kslhuy/CartePCB/Card_CRAN_SEGULA/Card_CRAN_SEGULA_BOM_F.xlsx

Reference | Qty | Description | Package | Manufacturer | Reference | Link
ANT1/ANT2 | 2 | U.FL (UMCC)/I-PEX MHFI_Impedance:50Ohm_max_freq:6GHz_see 3D picture for orientation" | Receptacle, Male Pin | Taoglas Limited | RECE.20279.001E.01 | https://www.digikey.fr/fr/products/detail/taoglas-limited/RECE-20279-001E-01/2332734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
BAT1 | 1 | NEGATIVE TERMINAL indicated by DOT on silkscreen | XT60 CONNECTOR | SparkFun Electronics | 10474 | https://www.digikey.fr/en/products/detail/sparkfun-electronics/10474/8258064
BAT2 | 1 | Connector Header Through Hole, Right Angle 2 position | 0.049" (1.25mm) | pin_2x1_0530480210:MOLEX_530480210 Molex | 530480210 | https://www.digikey.fr/en/products/detail/molex/0530480210/242864?s=N4IgTCBcDaIKwGYAMAWAHEsBGJIC6AvkA
C1 | 1 | 220nF_10%_16V_Ceramic_X7R | 0603 (1608 Metric) | KEMET | C0603C224K4RAC7411 | https://www.digikey.fr/en/products/detail/kemet/C0603C224K4RAC7411/12701088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
C78/C79 | 2 | 100nF_10%_50V_Ceramic_X7R | 0805 (2012 Metric) | KEMET | C0805X104K5RAC3316 | https://www.digikey.fr/en/products/detail/kemet/C0805X104K5RAC3316/10315793
C2/C3/C12/C73/C55/C56/C57/C58/C59/C60/C61/C62/C63/C64/C65/C37/C38/C39/C40/C41/C42/C43/C44/C45/C10/C11/C48/C51/C66/C70/C72/C32/C34/C86/C89 | 35 | 100nF_5%_50V_Ceramic_X7S | 0402 (1005 Metric) | Murata Electronics | GRM155C71H104JE19J | https://www.digikey.fr/en/products/detail/murata-electronics/GRM155C71H104JE19J/10702795
C15/C20 | 2 | 100nF_10%_16V_Ceramic_X7S | 0201 (0603 Metric) | Murata Electronics | GRM033C71C104KE14D | https://www.digikey.fr/en/products/detail/murata-electronics/GRM033C71C104KE14D/5027472
C46/C54 | 2 | 10uF_Molded Tantalum Polymer_10 V_ 200mOhm @ 100kHz (or 300mOhm)_1000 Hrs @ 105°C (or 85°C)8_Polarity indicated by + on silkscreen" | 0805 (2012 Metric) | KEMET | T529P106M010AAE200 | https://www.digikey.fr/en/products/detail/kemet/T529P106M010AAE200/8582783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
C4/C83/C84 | 2 | 10uF_10%_25V_Ceramic_X5R | 0603 (1608 Metric) | Murata Electronics | GRM188R61E106KA73J | https://www.digikey.fr/en/products/detail/murata-electronics/GRM188R61E106KA73J/9887674
C5 | 1 | 0.1uF_5%_50V Ceramic_X7S | 0402 (1005 Metric) | Murata Electronics | GRM155C71H104JE19D | https://www.digikey.fr/en/products/detail/murata-electronics/GRM155C71H104JE19D/8323490
C35/C36/C52/C53 | 4 | 2.2uF_10%_50V_Ceramic_X5R | 0603 (1608 Metric) | Murata Electronics | GRM188R61H225KE11D | https://www.digikey.fr/en/products/detail/murata-electronics/GRM188R61H225KE11D/4905363
C6 | 1 | 2.2uF_10%_50V_Ceramic_X5R | 0603 (1608 Metric) | Murata Electronics | GRM188R61H225KE11D | https://www.digikey.fr/en/products/detail/murata-electronics/GRM188R61H225KE11D/4905363
C76/C77 | 2 | 2.2 µF_10%_16V_Ceramic_X7R | 0805 (2012 Metric) | KEMET | C0805C225K4REC7210 | https://www.digikey.fr/en/products/detail/kemet/C0805C225K4REC7210/8645250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
C16 | 1 | 2.2uF_10%_16V_Ceramic_X7S | 0603 (1608 Metric) | Murata Electronics | GRM188C71C225KE11J | https://www.digikey.fr/en/products/detail/murata-electronics/GRM188C71C225KE11J/10697353
C21 | 1 | 2.2uF_Ceramic_25V_X5R_10% | 0402 (1005 Metric) | Murata Electronics | GRM155R61E225KE11D | https://www.digikey.fr/en/products/detail/murata-electronics/GRM155R61E225KE11D/4905143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
C29/C30 | 2 | 2.2uF_10%_16V_Ceramic_X7S | 0603 (1608 Metric) | Murata Electronics | GRM188C71C225KE11J | https://www.digikey.fr/en/products/detail/murata-electronics/GRM188C71C225KE11J/10697353
C7/C9/C19 | 3 | 10nF_Ceramic_25V_X7R_5% | 0402 (1005 Metric) | KEMET | C0402C103J3RACAUTO | https://www.digikey.fr/en/products/detail/kemet/C0402C103J3RACAUTO/9694225
C31/C33/C87/C88 | 4 | 1uF_10%_25V_Ceramic_X5R | 0603 (1608 Metric) | TDK Corporation | C1608X5R1E105K080AC | https://www.digikey.fr/en/products/detail/tdk-corporation/C1608X5R1E105K080AC/2093414
C47/C69/C71 | 3 | 1uF_Molded_Tantalum_10 V_7.5Ohm_Polarity indicated by + on silkscreen" | 0603 (1608 Metric) | KYOCERA AVX | TACL105K010XTA | https://www.digikey.fr/en/products/detail/kyocera-avx/TACL105K010XTA/1212738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
C8 | 1 | 1uF_-20%_+80%_25V_Ceramic_Y5V (F) | 0603 (1608 Metric) | KEMET | C0603C105Z3VACTU | https://www.digikey.fr/en/products/detail/kemet/C0603C105Z3VACTU/7382059
C22 | 1 | 1uF_10%_16V_Ceramic_X6S | 0402 (1005 Metric) | Murata Electronics | GRM155C81C105KE15D | https://www.digikey.fr/en/products/detail/murata-electronics/GRM155C81C105KE15D/10701217
C26 | 1 | 1uF_Ceramic_35V_X5R_10% | 0402 (1005 Metric) | Murata Electronics | GRM155R6YA105KE11D | https://www.digikey.fr/en/products/detail/murata-electronics/GRM155R6YA105KE11D/4905162
C18 | 1 | 1uF_Ceramic_10V_X7S_10% | 0402 (1005 Metric) | Murata Electronics | GCM155C71A105KE38D | https://www.digikey.fr/en/products/detail/murata-electronics/GCM155C71A105KE38D/6012263
C13/C23 | 2 | 0.47uF_Ceramic_6.3V_X5R_10% | 0201 (0603 Metric) | Murata Electronics | GRM033R60J474KE90J | https://www.digikey.fr/en/products/detail/murata-electronics/GRM033R60J474KE90J/10701512
C14/C24/C25/C27 | 4 | 4.7uF_Ceramic_25V_X6S_10% | 0603 (1608 Metric) | Murata Electronics | GRM188C81E475KE11D | https://www.digikey.fr/en/products/detail/murata-electronics/GRM188C81E475KE11D/3900460
C17 | 1 | 22nF_10%_10V_Ceramic_X5R | 0201 (0603 Metric) | Murata Electronics | GRM033R61A223KE84D | https://www.digikey.fr/en/products/detail/murata-electronics/GRM033R61A223KE84D/4904684
C28 | 1 | 0.22uF_Ceramic_10V_X5R_10% | 0201 (0603 Metric) | Murata Electronics | GRM033R61A224KE90D | https://www.digikey.fr/en/products/detail/murata-electronics/GRM033R61A224KE90D/5027496
C49/C50/C67/C68 | 4 | 10pF_5%_50V_Ceramic_C0G_NP0 | 0402 (1005 Metric) | KYOCERA AVX | KGM05ACG1H100JH | https://www.digikey.fr/en/products/detail/kyocera-avx/KGM05ACG1H100JH/563180
C74/C82 | 2 | 100 µF_35V_Aluminum Electrolytic_160mOhm @ 100kHz_2000 Hrs @ 105°C_Low ESR_High Ripple Current_Polarity indicated by + on silkscreen | Radial, Can - SMD | Panasonic Electronic Components | EEE-FPV101XAV | https://www.digikey.fr/en/products/detail/panasonic-electronic-components/EEE-FPV101XAV/10290451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
C75/C81 | 2 | 47uF_20% 35V Ceramic Capacitor X7R_Low ESL | 2220 (5750 Metric) | TDK Corporation | C5750X7R1V476M230KC | https://www.digikey.fr/en/products/detail/tdk-corporation/C5750X7R1V476M230KC/15930210
C80 | 1 | 4.7nF_5%_25V_Ceramic_C0G_NP0 | 0805 (2012 Metric) | KEMET | C0805C472J3GEC7210 | https://www.mouser.fr/ProductDetail/KEMET/C0805C472J3GEC7210?qs=55YtniHzbhA1RCOcrQWbQg%3D%3D
C85 | 1 | 22pF_5%_10V_Ceramic_C0G_NP0 | 0402 (1005 Metric) | KEMET | C0402C220J8GACTU | https://www.digikey.fr/en/products/detail/kemet/C0402C220J8GACTU/2196440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
D1/D13 | 2 | Blue 470nm LED Indication - Discrete 3.2V | 0603 (1608 Metric) | Dialight | 5990091007F | https://www.digikey.fr/en/products/detail/dialight/5990091007F/9385407?s=N4IgTCBcDaIKwE4EAZkIIyoOwDEQF0BfIA
D3/D5/D7/D9/D15 | 5 | DIODE SCHOTTKY 40V 350MA_Surface Mount | SOD-323 | Diodes Incorporated | SD103AWS-7-F | https://www.digikey.fr/en/products/detail/diodes-incorporated/SD103AWS-7-F/717797
D10/D11 | 2 | Red 633nm LED Indication - Discrete 2.1V | 0603 (1608 Metric) | Dialight | 5990010007F | https://www.digikey.fr/en/products/detail/dialight/5990010007F/9385401?s=N4IgTCBcDaIKwE4EAZkEZXIOwDEQF0BfIA
D12/D14 | 2 | Yellow 590nm LED Indication - Discrete 2.1V | 0603 (1608 Metric) | Dialight | 5990040007F | https://www.digikey.fr/en/products/detail/dialight/5990040007F/9385404?s=N4IgTCBcDaIKwE4EAZkBZXIOwDEQF0BfIA
D16/D17 | 2 | Green 525nm LED Indication - Discrete 3.1V | 0603 (1608 Metric) | Dialight | 5990081007F | https://www.digikey.fr/en/products/detail/dialight/5990081007F/9385406?s=N4IgTCBcDaIKwE4EAZkA4CMqDsAxEAugL5A
FB1/FB3/FB5/FB7/FB9/FB10 | 6 | 120 Ohms @ 100 MHz 1 Power Line Ferrite Bead_2A 55mOhm | 0402 (1005 Metric) | TDK Corporation | MPZ1005S121HT000 | https://www.digikey.fr/en/products/detail/tdk-corporation/MPZ1005S121HT000/6816995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
IC1 | 1 | ARM® Cortex®-M4 STM32F4 Microcontroller IC 32-Bit Single-Core 168MHz 1MB (1M x 8) | 64-LQFP (10x10) | STMicroelectronics | STM32F405RGT6 | https://www.digikey.fr/en/products/detail/stmicroelectronics/STM32F405RGT6/2754208
IC2 | 1 | ARM® Cortex®-M7 STM32H7 Microcontroller IC 32-Bit Single-Core 480MHz 2MB (2M x 8) FLASH | 100-LQFP (14x14) | STMicroelectronics | STM32H753VIT6 | https://www.digikey.fr/en/products/detail/stmicroelectronics/STM32H753VIT6/8257854
J1 | 1 | 9 (8 + 1) Position Card Connector and Ejector Secure Digital - microSD™ Surface Mount_Right Angle Gold |  | Molex | 5033981892 | https://www.digikey.fr/en/products/detail/molex/5033981892/4555393?s=N4IgTCBcDaIKwAYDMSCcAOAtARnaiAugL5A
J2/J3/J4/J5 | 4 | USB 2.0 Receptacle Connector 24 (16+8 Dummy) Position Surface Mount_Right Angle_Solder_See attached 3D picture for orientation | USB-C (USB TYPE-C) | GCT | USB4110-GF-A | https://www.digikey.fr/en/products/detail/gct/USB4110-GF-A/10384547?s=N4IgTCBcDaIKoGUBCAWAjGgDAcQGIEEQBdAXyA
J6/J7 | 2 | Connector Header Surface Mount 10 position | 0.050" (1.27mm) | Harwin Inc. | M50-3600542R | https://www.digikey.fr/en/products/detail/harwin-inc/M50-3600542R/4969871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
J9/J11/J12/J13/J14/J15 | 6 | Connector Header Through Hole, Right Angle 4 position | 0.049" (1.25mm) | Molex | 530480410 | https://www.digikey.fr/en/products/detail/molex/0530480410/242866?s=N4IgTCBcDaIKwGYAMAWAHKgjEkBdAvkA
J16 | 1 | Connector Header Through Hole, Right Angle 6 position | 0.049" (1.25mm) | Molex | 530480610 | https://www.digikey.fr/en/products/detail/molex/0530480610/242868?s=N4IgTCBcDaIKwGYAMAWAHEgbARiSAugL5A
L1 | 1 | 27nH_Unshielded Drum Core_Wirewound_680 mA_288mOhm Max | 0402 (1005 Metric) | Murata Electronics | LQW15AN27NJ8ZD | https://www.digikey.fr/en/products/detail/murata-electronics/LQW15AN27NJ8ZD/6798799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
L2 | 1 | 3.3µH_Unshielded Multilayer_1A_200mOhm | 0805 (2012 Metric) | Würth Elektronik | 74479775233 | https://www.digikey.fr/en/products/detail/w%C3%BCrth-elektronik/74479775233/4862368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
L3 | 1 | 15uH_Shielded Drum Core, Wirewound Inductor 9A 28mOhm Max | 0.531" L x 0.492" W (13.50mm x 12.50mm) | Bourns Inc. | SRP1265A-150M | https://www.digikey.fr/en/products/detail/bourns-inc/SRP1265A-150M/4876621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
R1/R50/R51 | 4 | 10R_0.5%_0.063W_1/16W_Thin Film | 0402 (1005 Metric) | Panasonic Electronic Components | ERA-2AKD100X | https://www.digikey.fr/en/products/detail/panasonic-electronic-components/ERA-2AKD100X/1706054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
R2/R3/R4/R34/R35/R52/R42/R43/R44/R45/R46/R61 | 12 | 10kR_1%_0.125W_1/8W_Thick Film | 0402 (1005 Metric) | TE Connectivity Passive Product | CRGP0402F10K | https://www.digikey.fr/en/products/detail/te-connectivity-passive-product/CRGP0402F10K/8576969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
R63/R64 | 2 | 10 kR_5%_0.25W_1/4W_Thick Film | 0805 (2012 Metric) | Panasonic Electronic Components | ERJ-T06J103V | https://www.digikey.fr/en/products/detail/panasonic-electronic-components/ERJ-T06J103V/2340195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
R5/R41 | 2 | 100R_0.5%_0.333W_1/3W_Thick Film | 0603 (1608 Metric) | Panasonic Electronic Components | ERJ-PA3D1000V | https://www.digikey.fr/en/products/detail/panasonic-electronic-components/ERJ-PA3D1000V/5038262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
R8/R14/R20/R23/R25/R26/R27/R30 | 8 | 100kR_1%_0.1W_1/10W_Thick Film | 0402 (1005 Metric) | Panasonic Electronic Components | ERJ-2RKF1003X | https://www.digikey.fr/en/products/detail/panasonic-electronic-components/ERJ-2RKF1003X/192081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
R9/R17/R21/R22/R24/R28/R29/R31 | 8 | 5.1kR_1%_0.1W_1/10W_Thick Film | 0402 (1005 Metric) | KOA Speer Electronics, Inc. | RK73H1ETTP5101F | https://www.digikey.fr/en/products/detail/koa-speer-electronics-inc/RK73H1ETTP5101F/9844118
R18/R33 | 2 | 1kR_1%_0.063W_1/16W_Thick Film | 0402 (1005 Metric) | YAGEO | RC0402FR-071KL | https://www.digikey.fr/en/products/detail/yageo/RC0402FR-071KL/726513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
R19/R32/R40/R60 | 4 | 330R_0.5%_0.333W_1/3W_Thick Film | 0603 (1608 Metric) | Panasonic Electronic Components | ERJ-PA3D3300V | https://www.digikey.fr/en/products/detail/panasonic-electronic-components/ERJ-PA3D3300V/5038319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
R36/R37/R38/R39/R53/R54/R55/R56 | 8 | 4.7kR_1%_0.2W_1/5W_Thick Film | 0402 (1005 Metric) | KOA Speer Electronics, Inc. | SG73P1ETTP4701F | https://www.digikey.fr/en/products/detail/koa-speer-electronics-inc/SG73P1ETTP4701F/10188081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
R57 | 1 | 47R_0.5%_0.063W_1/16W_Thin Film | 0402 (1005 Metric) | Panasonic Electronic Components | ERA-2AED470X | https://www.digikey.fr/en/products/detail/panasonic-electronic-components/ERA-2AED470X/1706070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
R62 | 1 | 0.01R_1%_2W | 2512 (6432 Metric) | YAGEO | PE2512FKE7W0R01Z | https://www.digikey.fr/en/products/detail/yageo/PE2512FKE7W0R01Z/12698905
R65 | 1 | 19.6kR_0.1%_0.25W_1/4W_Thick Film | 0805 (2012 Metric) | Panasonic Electronic Components | ERJ-PB6B1962V | https://www.digikey.fr/en/products/detail/panasonic-electronic-components/ERJ-PB6B1962V/6213522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
R66 | 1 | 6.8kR_1%_0.25W_1/4W_Thick Film | 0805 (2012 Metric) | KOA Speer Electronics, Inc. | RK73H2ATTD6R80F | https://www.digikey.fr/en/products/detail/koa-speer-electronics-inc/RK73H2ATTD6R80F/10233949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
R67 | 1 | 1.3kR_1% _0.25W_1/4W_Thick Film | 0805 (2012 Metric) | KOA Speer Electronics, Inc. | RK73H2ATTD1301F | https://www.digikey.fr/en/products/detail/koa-speer-electronics-inc/RK73H2ATTD1301F/10234163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
R68 | 1 | 560R_1%_0.333W_1/3W_Thick Film | 0603 (1608 Metric) | Panasonic Electronic Components | ERJ-PA3F5600V | https://www.digikey.fr/en/products/detail/panasonic-electronic-components/ERJ-PA3F5600V/5035938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
R69 | 1 | 240R_1%_0.333W_1/3W_Thick Film | 0603 (1608 Metric) | Panasonic Electronic Components | ERJ-PA3F2400V | https://www.digikey.fr/en/products/detail/panasonic-electronic-components/ERJ-PA3F2400V/5035893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
R70/R71 | 2 | 620R_1%_0.333W_1/3W_Thick Film | 0603 (1608 Metric) | Panasonic Electronic Components | ERJ-PA3F6200V | https://www.digikey.fr/en/products/detail/panasonic-electronic-components/ERJ-PA3F6200V/5035943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
R72/R76 | 2 | 22.1kR_1%_0.063W_1/16W_Thick Film | 0402 (1005 Metric) | YAGEO | RC0402FR-0722K1L | https://www.digikey.fr/en/products/detail/yageo/RC0402FR-0722K1L/726563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
R73/R77 | 2 | 47.5kR_1%_0.1W_1/10W_Thick Film | 0402 (1005 Metric) | KOA Speer Electronics, Inc. | RK73H1ETTP4752F | https://www.digikey.fr/en/products/detail/koa-speer-electronics-inc/RK73H1ETTP4752F/9844111
R74/R75 | 2 | 0R_Jumper_1/8W_Thick Film | 0603 (1608 Metric) | Vishay Dale | RCS06030000Z0EC | https://www.digikey.fr/en/products/detail/vishay-dale/RCS06030000Z0EC/10059623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
REG1 | 1 | Buck Switching Regulator IC Positive Adjustable 0.8V 1 Output 9A | 28-QFN (5x6) | Microchip Technology | MIC26903YJL-TR | https://www.digikey.fr/en/products/detail/microchip-technology/MIC26903YJL-TR/2747223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
SW1/SW2/SW4 | 3 | Dip Switch SPDT 2 Position Surface Mount Slide (Standard) Actuator 25mA 24VDC | 0.236" (6.00mm) | C&K | TDD01H0SB1R | https://www.digikey.fr/en/products/detail/c-k/TDD01H0SB1R/4966368?s=N4IgTCBcDaICoBEEAYCMAJZBlAQqgSiALoC%2BQA
SW3/SW5 | 2 | Tactile Switch SPST-NO 0.05A 12V Top Actuated Surface Mount |  | Alps Alpine | SKQGADE010 | https://www.digikey.fr/en/products/detail/alps-alpine/SKQGADE010/18109115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
TP1/TP2/TP3/TP4 | 4 | TestPoint | Pad_D1.5mm
U1 | 1 | Magnetoresistive Sensor X, Y, Z Axis | 12-LGA (2x2) | STMicroelectronics | IIS2MDCTR | https://www.digikey.fr/en/products/detail/stmicroelectronics/IIS2MDCTR/7927708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
U2 | 1 | Accelerometer X, Y, Z Axis ±2g, 4g, 8g, 16g 6.25Hz ~ 16kHz | 14-LGA (2.5x3) | TDK InvenSense | IIM-42652 | https://www.digikey.fr/en/products/detail/tdk-invensense/IIM-42652/13901975
U3 | 1 | M9 RF Receiver BeiDou, Galileo, GLONASS, GNSS, GPS -167dBm | 24-SMD Module | u-blox | NEO-M9N-00B | https://www.digikey.fr/en/products/detail/u-blox/NEO-M9N-00B/12149174
U4/U5 | 2 | EEPROM Memory IC 128Kbit I2C 1 MHz 450 ns | SC-74A/SOT-753 | Microchip Technology | 24CW1280T-I/OT | https://www.digikey.fr/en/products/detail/microchip-technology/24CW1280T-I-OT/9606899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
U6 | 1 | IC RF TxRx Only WiFi 802.11a/b/g/-c/ax, Bluetooth, GPS 2.4GHz, 5GHz | 48-VFQFN Exposed Pad | Nordic Semiconductor ASA | NRF7002-QFAA-R | https://www.digikey.fr/en/products/detail/nordic-semiconductor-asa/NRF7002-QFAA-R/17738488
U7 | 1 | FLASH - NAND Memory IC 1Gbit SPI 104 MHz | 8-WDFN Exposed Pad | Winbond Electronics | W25N01GVZEIG TR | https://www.digikey.fr/en/products/detail/winbond-electronics/W25N01GVZEIG-TR/5803931
U8 | 1 | RF Diplexer 2.4GHz ~ 2.5GHz / 4.9GHz ~ 5.95GHz | 0603 (1608 Metric), 6 PC Pad | TDK Corporation | DPX165950DT-8148A1 | https://www.digikey.fr/en/products/detail/tdk-corporation/DPX165950DT-8148A1/6468701
U9/U10 | 2 | USB Bridge, USB to UART USB 2.0 UART Interface | 20-QFN (3x3) | Silicon Labs | CP2102N-A02-GQFN20R | https://www.digikey.fr/en/products/detail/silicon-labs/CP2102N-A02-GQFN20R/9863478
U11 | 1 | Current Monitor Regulator High-Side 10mA | SOT-23-8 | Texas Instruments | INA219AIDCNR | https://www.digikey.fr/en/products/detail/texas-instruments/INA219AIDCNR/1952540
U12 | 1 | Linear Voltage Regulator IC Positive Fixed 1 Output 2A | 6-DFN (3x3) | STMicroelectronics | LD39200PU33R | https://www.mouser.fr/ProductDetail/STMicroelectronics/LD39200PU33R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
U13/U14 | 2 | 17V Clamp 5A (8/20µs) Ipp Tvs Diode Surface Mount | SOT-23-6 | STMicroelectronics | USBLC6-2SC6 | https://www.digikey.fr/en/products/detail/stmicroelectronics/USBLC6-2SC6/1040559
X1 | 1 | 40 MHz ±10ppm Crystal 8pF 50 Ohms 4-SMD, No Lead | 0.079" L x 0.063" W (2.00mm x 1.60mm) | Diodes Incorporated | FW4000044Q | https://www.digikey.fr/en/products/detail/diodes-incorporated/FW4000044Q/9952926
X2/X3 | 2 | 25 MHz ±30ppm Crystal 10pF 60 Ohms | 4-SMD (3.2x2.5) | Abracon LLC | ABM8G-25.000MHZ-4Y-T3 | https://www.digikey.fr/en/products/detail/abracon-llc/ABM8G-25-000MHZ-4Y-T3/2623797
JP1, JP6 | 2 | SolderJumper-3_Pole | 1.3mm_Open_RoundedPad1.0x1.5mm
H1/H2/H3/H4 | 4 | MountingHole_3.2mm_M3_Pad_Via_PTH
