kslhuy/CartePCB/nav_f405_test/calibration/accel_6pos_calibration.png

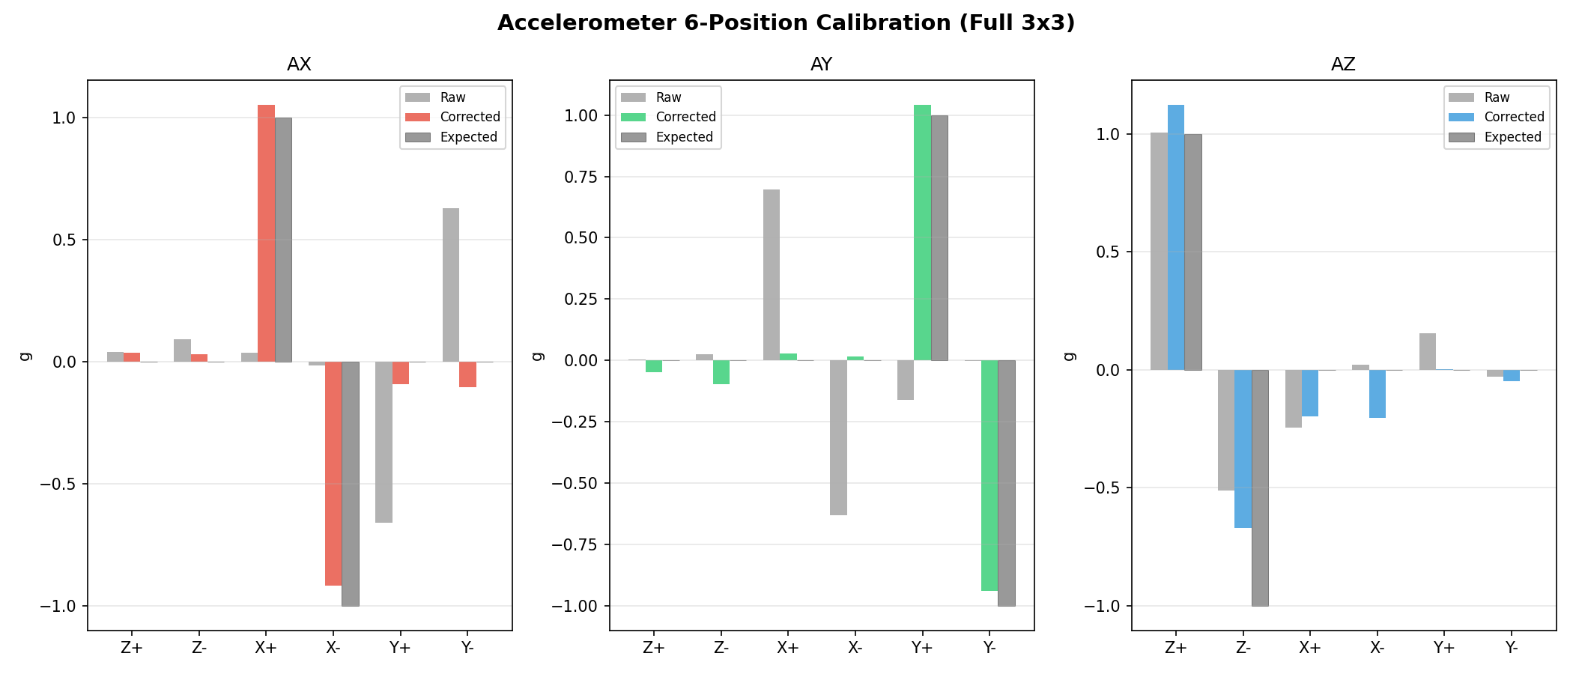
nav_f405_test/calibration/accel_6pos_calibration.png
