kslhuy/CartePCB/nav_f405_test/calibration/allan_deviation.png

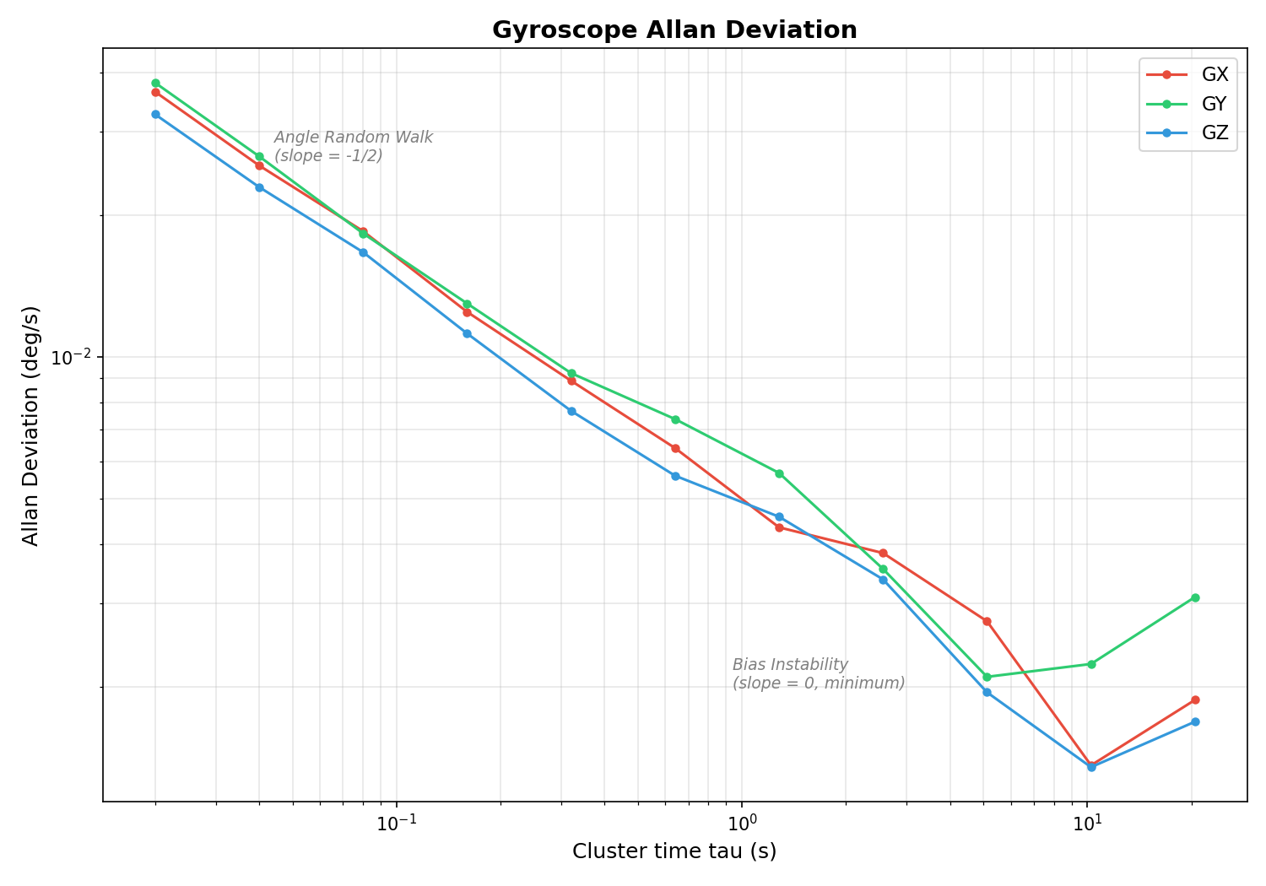
nav_f405_test/calibration/allan_deviation.png
