kslhuy/CartePCB/nav_f405_test/calibration/ferraris_calibration.png

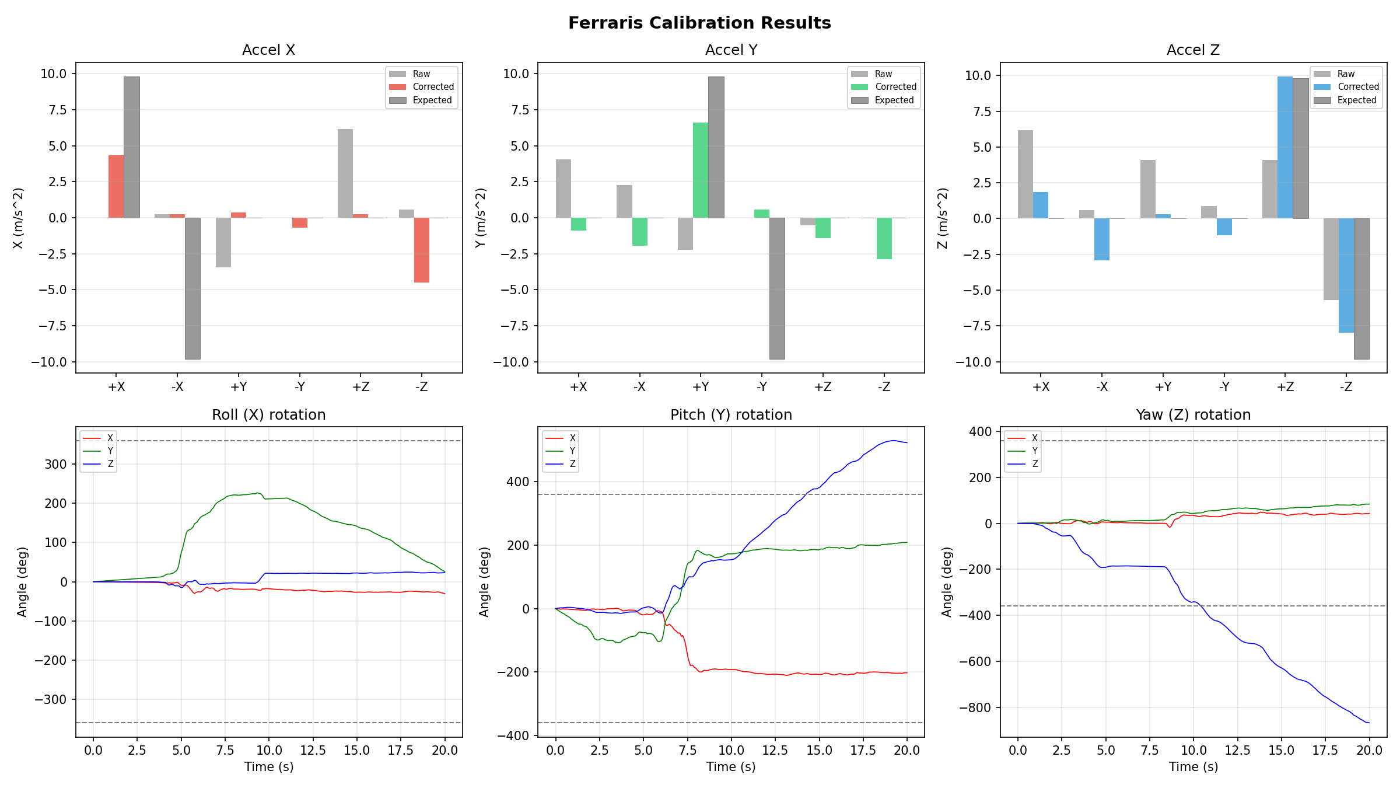
nav_f405_test/calibration/ferraris_calibration.png
