kslhuy/CartePCB/nav_f405_test/calibration/gyro_noise_analysis.png

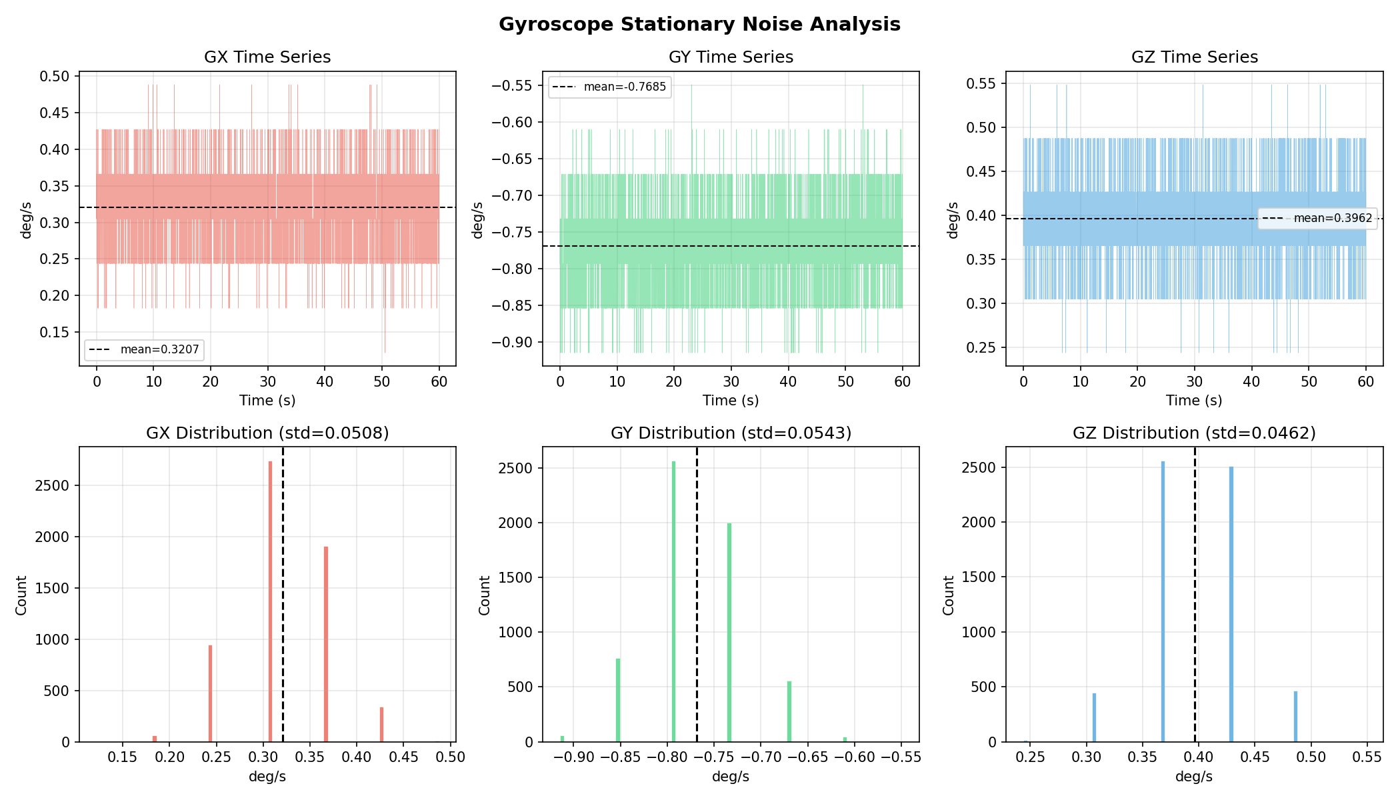
nav_f405_test/calibration/gyro_noise_analysis.png
