kslhuy/CartePCB/nav_f405_test/calibration/imu_analysis.png

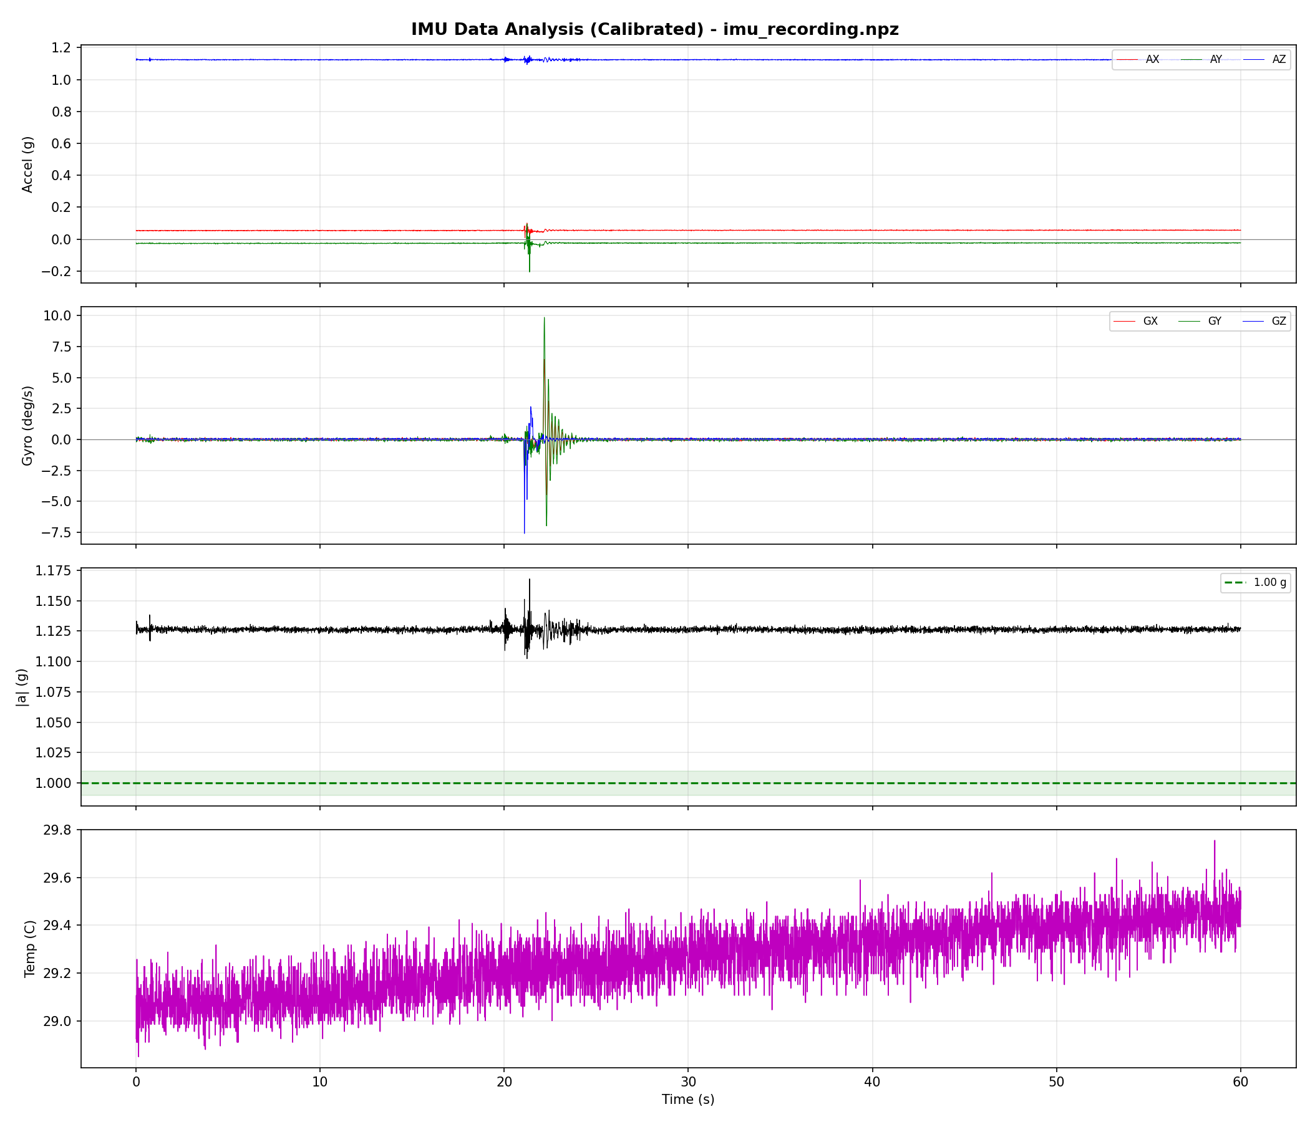
nav_f405_test/calibration/imu_analysis.png
