kslhuy/CartePCB/nav_f405_test/calibration/imu_statistics.png

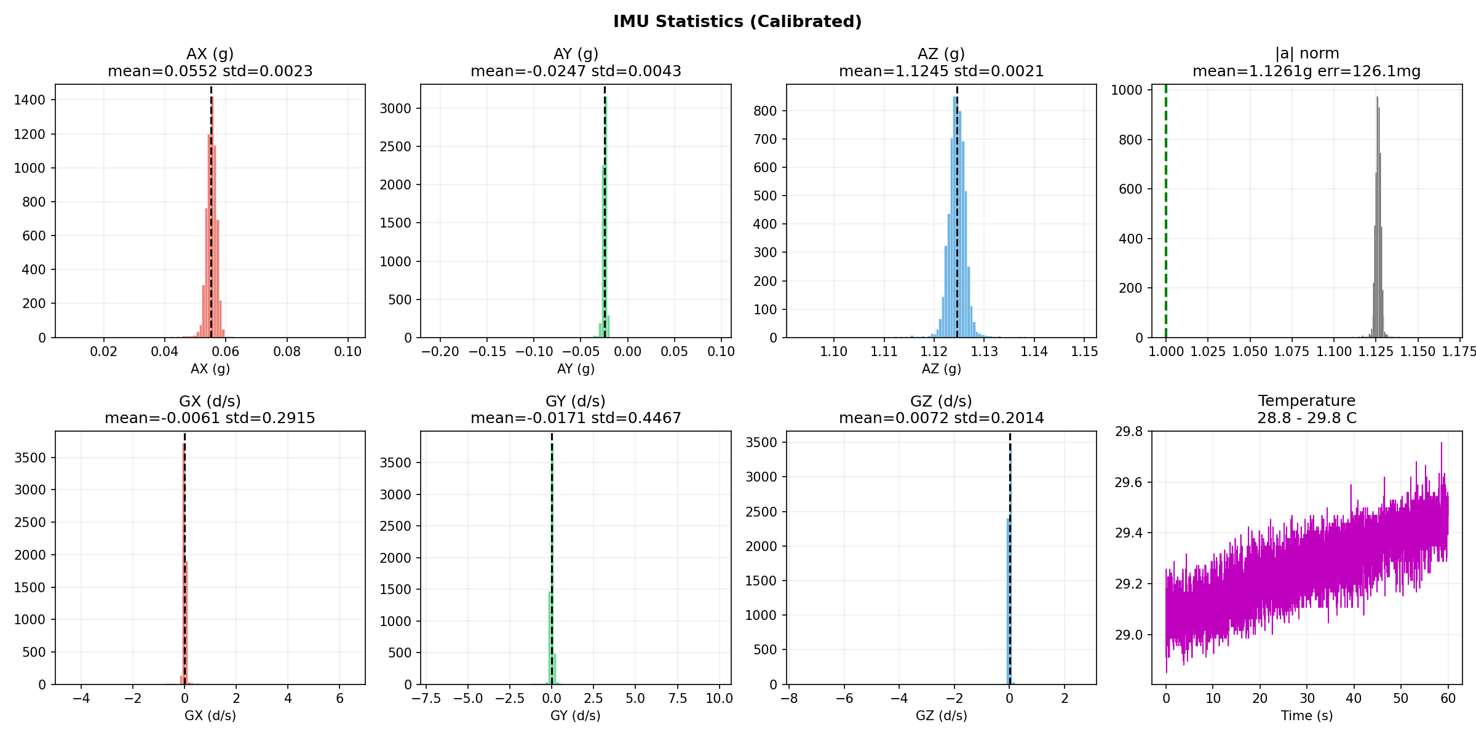
nav_f405_test/calibration/imu_statistics.png
