kslhuy/CartePCB/nav_f405_test/calibration/raw_vs_calibrated.png

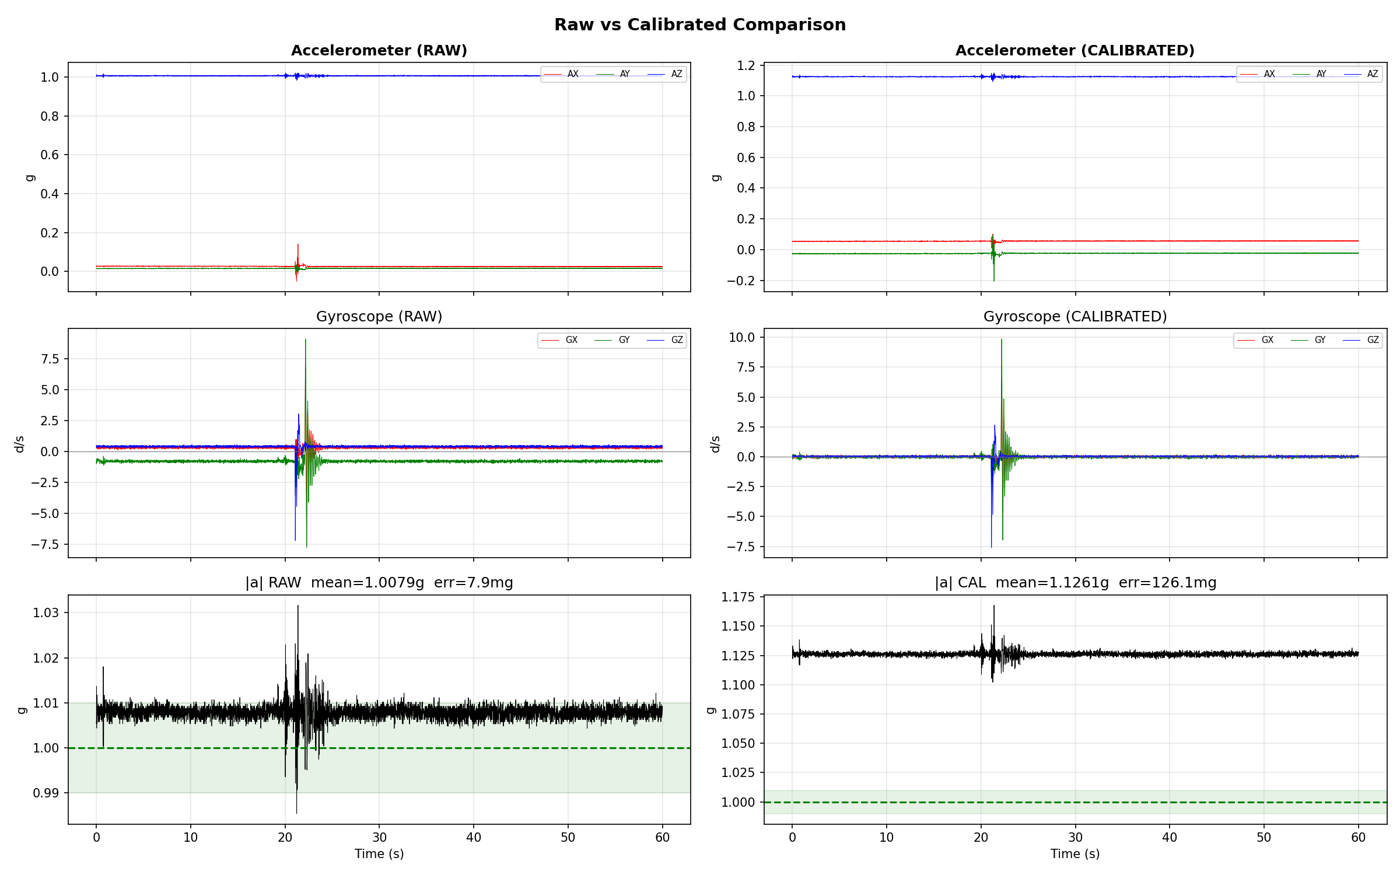
nav_f405_test/calibration/raw_vs_calibrated.png
