kslhuy/CartePCB/Card_CRAN_SEGULA/Card_CRAN_SEGULA.kicad_pcb

## KiCad design Card_CRAN_SEGULA/Card_CRAN_SEGULA.kicad_pcb (2026-03-03)

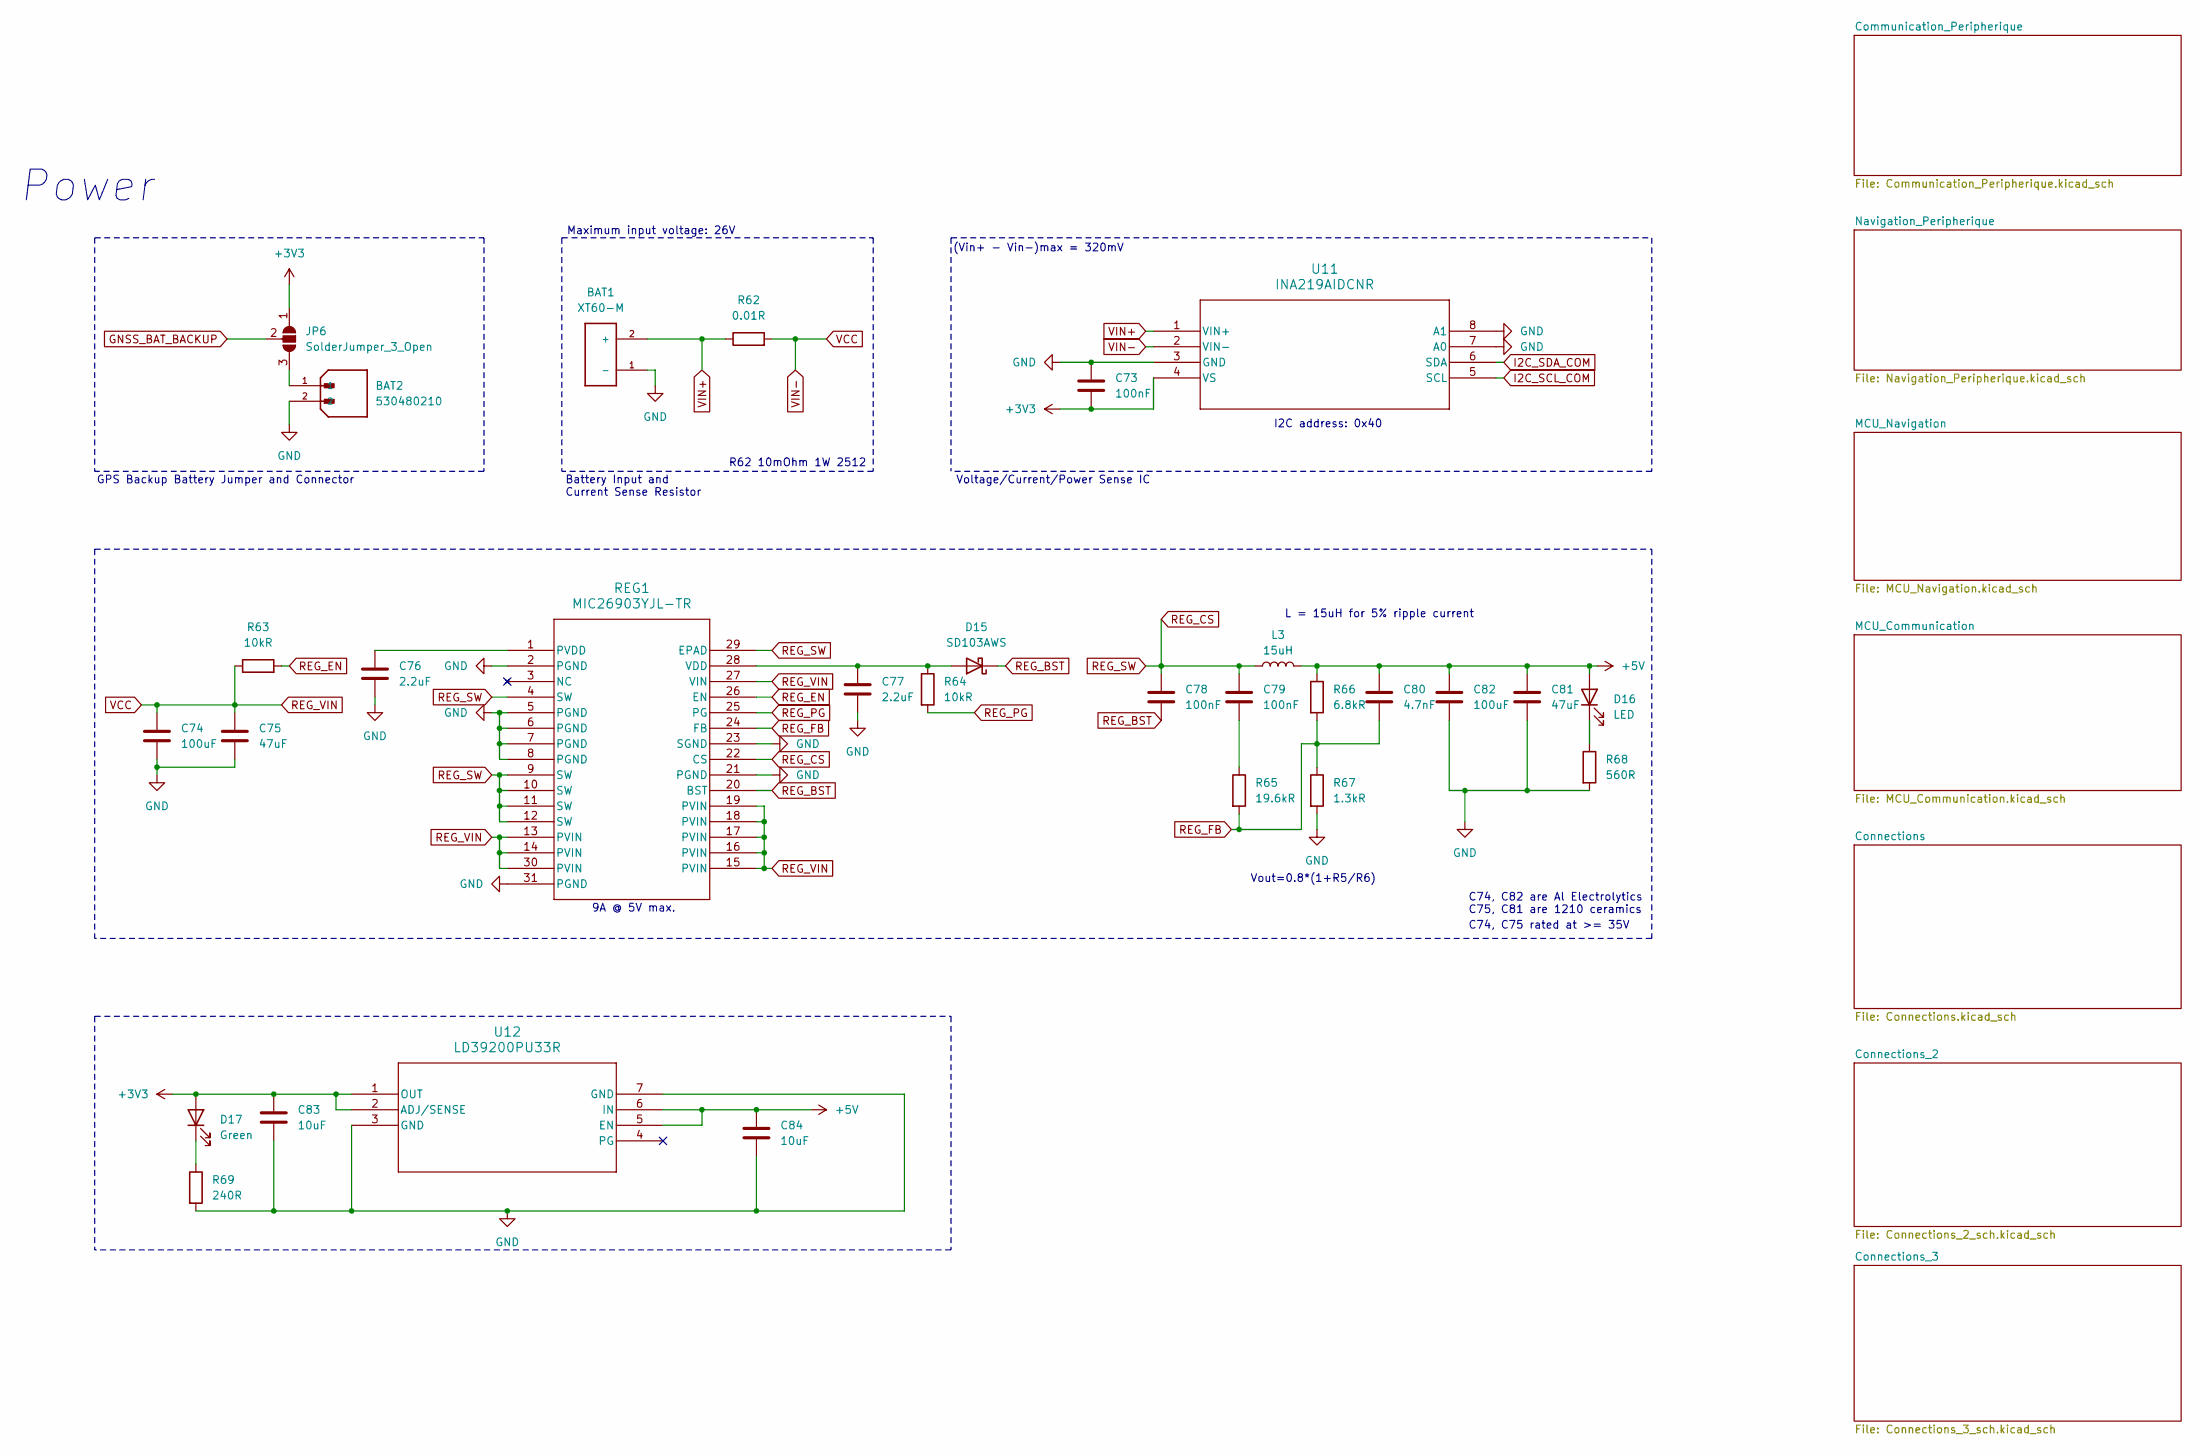
[picture p8: schematic Card_CRAN_SEGULA.kicad_sch, Carte_Embarquée_CRAN_SEGULA]

Parts:
BAT1: XT60-M; AMASS_XT60-M
BAT2: 530480210; MOLEX_530480210; PARTREV A
C73: 100nF; CAPC1005X55N
C74, C82: 100uF; CAP_EEEFPV101XAV
C75, C81: 47uF; CAP_C5750X7R1V476M230KC
C76, C77: 2.2uF; CAPC220145_140N_KEM
C78, C79: 100nF; CAPC230155_120N_KEM
C80: 4.7nF; CAPC220145_100N_KEM
C83, C84: 10uF; CAPC1608X100N
D15: SD103AWS; D_SOD-323
D16: LED; 599-0081-007F_DIA
D17: Green; 599-0081-007F_DIA
JP6: SolderJumper_3_Open; SolderJumper-3_P1.3mm_Open_RoundedPad1.0x1.5mm
L3: 15uH; IND_SRP1265A-150M
R62: 0.01R; RES_PE2512_YAG
R63, R64: 10kR; RESC2012X70N
R65: 19.6kR; RES_ERJ-PB6B1962V
R66: 6.8kR; RESC2012X60N
R67: 1.3kR; RK73H2ATTD1301F
R68: 560R; RES_ERJPA3F5600V
R69: 240R; RES_ERJPA3F2400V
REG1: MIC26903YJL-TR; MIC24054YJLTR
U11: INA219AIDCNR; DCN8
U12: LD39200PU33R; SON_DFN6_3X3_STM

Connections:
+5V: C80.1, C81.1, C82.1, C84.1, D16.2 (A), L3.2, R66.1, U12.5 (EN), U12.6 (IN); also elsewhere on the board
GND: BAT1.1 (-), BAT2.2, C73.1, C74.2, C75.2, C76.2, C77.2, C81.2, C82.2, C83.2, C84.2, R67.2, R68.2, R69.2, REG1.2 (PGND), REG1.5 (PGND), REG1.6 (PGND), REG1.7 (PGND), REG1.8 (PGND), REG1.21 (PGND), REG1.23 (SGND), REG1.31 (PGND), U11.3 (GND), U11.7 (A0), U11.8 (A1), U12.3 (GND), U12.7 (GND); also elsewhere on the board
GNSS_BAT_BACKUP: JP6.2 (C); also elsewhere on the board
I2C_SCL_COM: U11.5 (SCL); also elsewhere on the board
I2C_SDA_COM: U11.6 (SDA); also elsewhere on the board
unnamed: C79.2, R65.1
unnamed: C77.1, D15.2 (A), R64.1, REG1.28 (VDD)
unnamed: D16.1 (K), R68.1
unnamed: D17.1 (K), R69.1
unnamed: BAT2.1, JP6.3 (B)
unnamed: C76.1, REG1.1 (PVDD)
REG_BST: C78.2, D15.1 (K), REG1.20 (BST)
REG_CS: C78.1, C79.1, L3.1, REG1.4 (SW), REG1.9 (SW), REG1.10 (SW), REG1.11 (SW), REG1.12 (SW), REG1.22 (CS), REG1.29 (EPAD)
REG_EN: R63.2, REG1.26 (EN)
REG_FB: C80.2, R65.2, R66.2, R67.1, REG1.24 (FB)
REG_PG: R64.2, REG1.25 (PG)
REG_VIN: C74.1, C75.1, R62.2, R63.1, REG1.13 (PVIN), REG1.14 (PVIN), REG1.15 (PVIN), REG1.16 (PVIN), REG1.17 (PVIN), REG1.18 (PVIN), REG1.19 (PVIN), REG1.27 (VIN), REG1.30 (PVIN), U11.2 (VIN-)
VIN+: BAT1.2 (+), R62.1, U11.1 (VIN+)
WIFI_BUCVBATS: C73.2, C83.1, D17.2 (A), JP6.1 (A), U11.4 (VS), U12.1 (OUT), U12.2 (ADJ/SENSE); also elsewhere on the board

Notes on the sheet:
Vout=0.8*(1+R5/R6)
R62 10mOhm 1W 2512
Maximum input voltage: 26V
9A @ 5V max.
Battery Input and Current Sense Resistor
I2C address: 0x40
C74, C82 are Al Electrolytics C75, C81 are 1210 ceramics
L = 15uH for 5% ripple current
Voltage/Current/Power Sense IC
GPS Backup Battery Jumper and Connector
(Vin+ - Vin-)max = 320mV
C74, C75 rated at >= 35V
Power

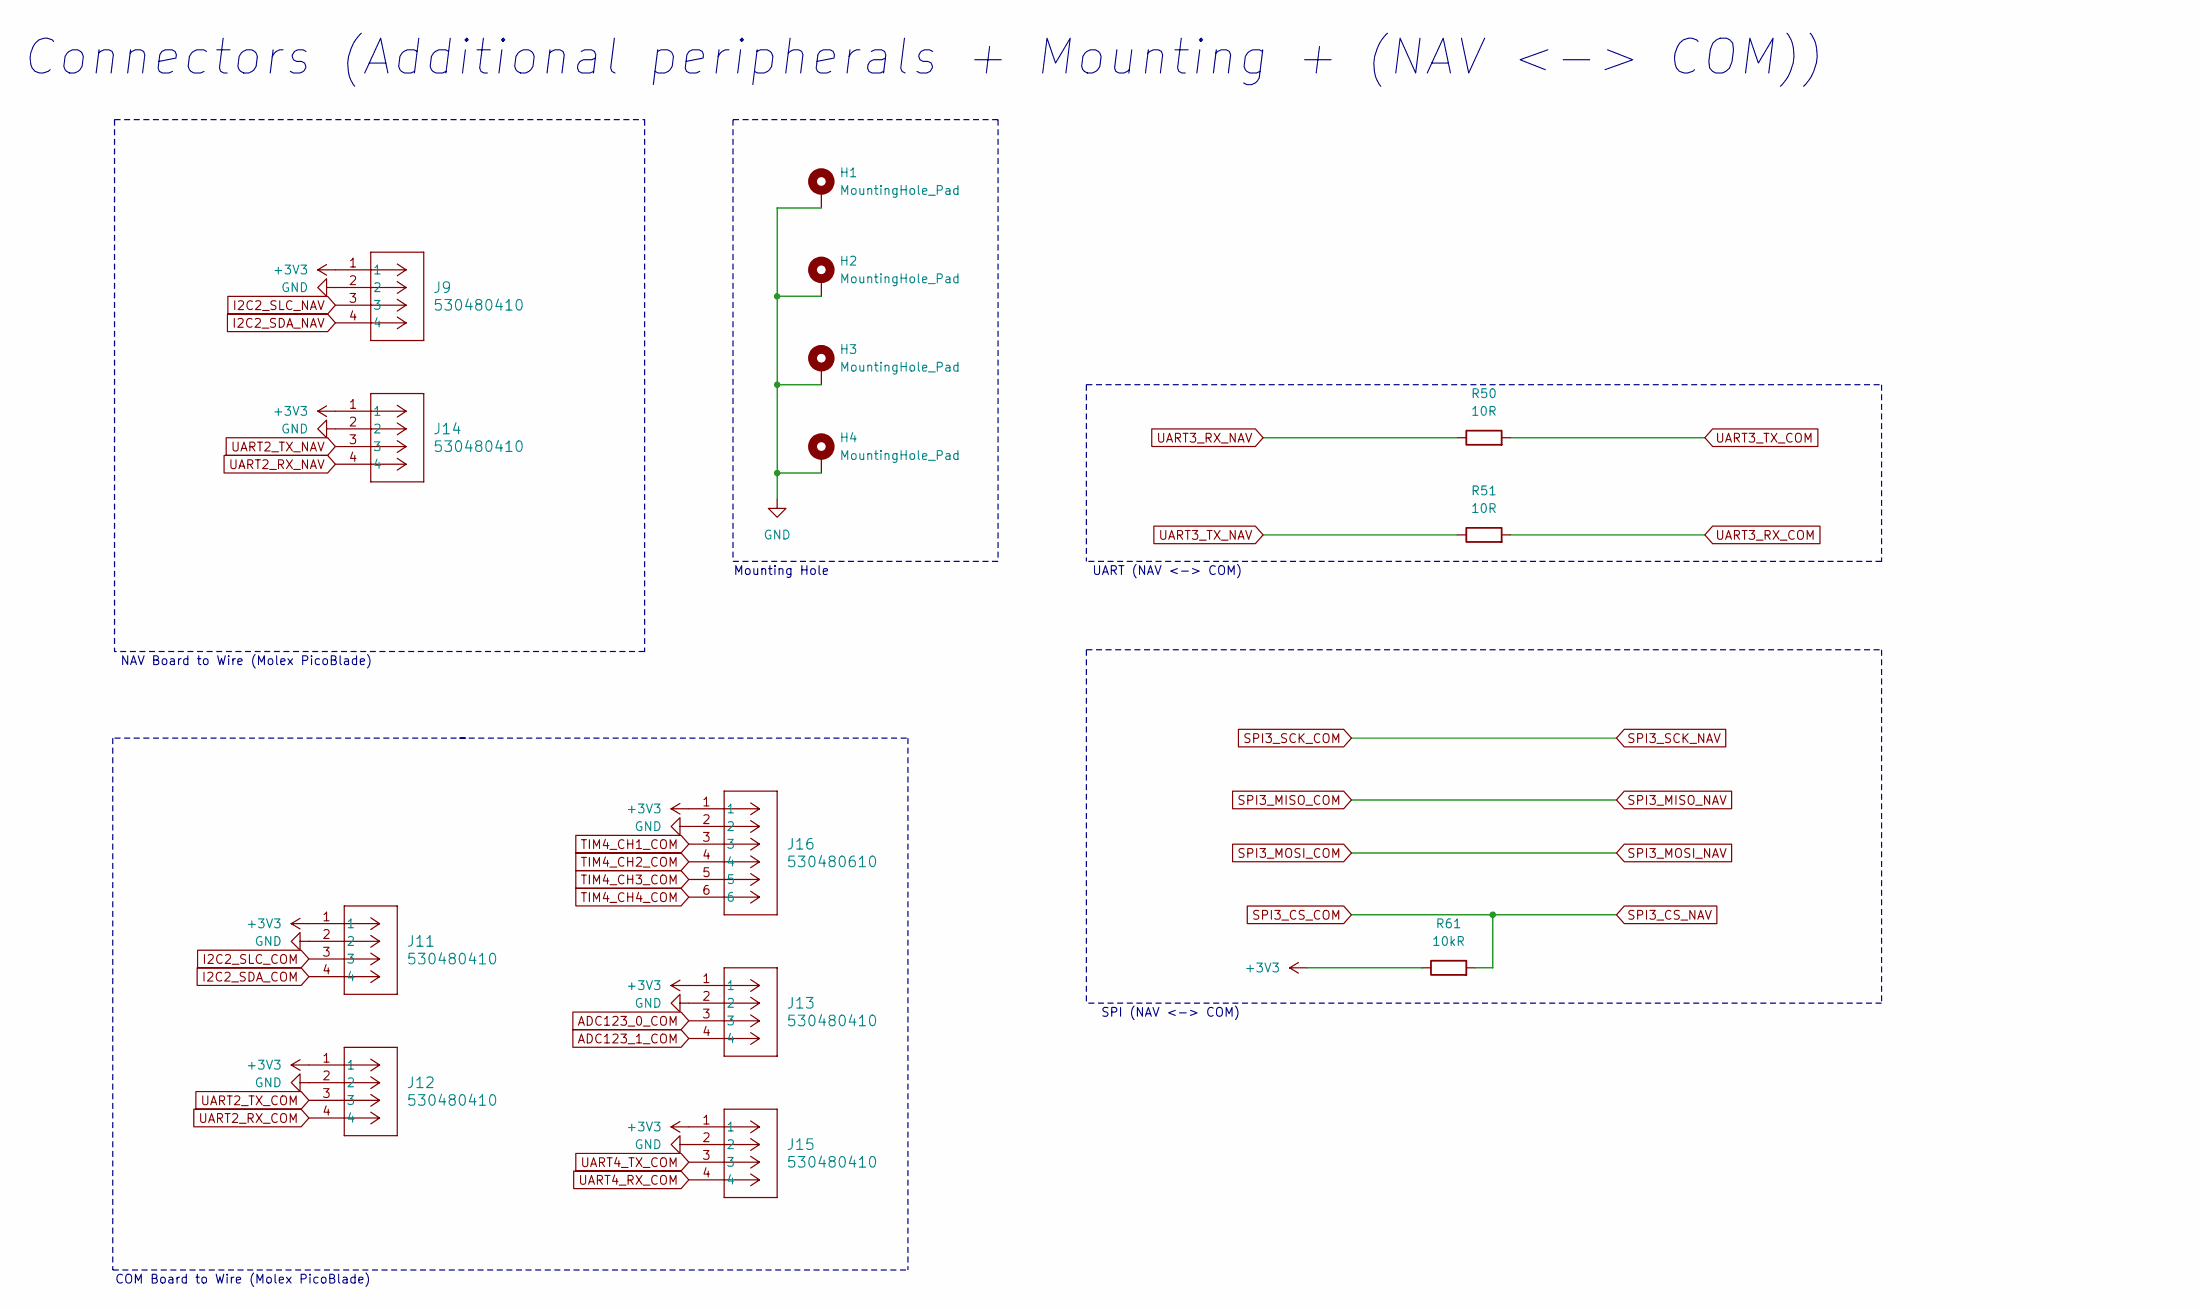
[picture p9: schematic Connections_3_sch.kicad_sch, Carte_Embarquée_CRAN_SEGULA]

Parts:
H1, H2, H3, H4: MountingHole_Pad; MountingHole_3.2mm_M3_Pad_Via
J9, J11, J12, J13, J14, J15: 530480410; CONN04_530480410_MOL
J16: 530480610; CONN06_530480610_MOL
R50, R51: 10R; RES_ERA2AKD100X
R61: 10kR; RESC1105X40N

Connections:
ADC123_0_COM: J13.3; also elsewhere on the board
ADC123_1_COM: J13.4; also elsewhere on the board
GND: H1.1, H2.1, H3.1, H4.1, J9.2, J11.2, J12.2, J13.2, J14.2, J15.2, J16.2; also elsewhere on the board
I2C2_SDA_COM: J11.4; also elsewhere on the board
I2C2_SDA_NAV: J9.4; also elsewhere on the board
I2C2_SLC_COM: J11.3; also elsewhere on the board
I2C2_SLC_NAV: J9.3; also elsewhere on the board
SPI3_CS_COM: R61.2; also elsewhere on the board
TIM4_CH1_COM: J16.3; also elsewhere on the board
TIM4_CH2_COM: J16.4; also elsewhere on the board
TIM4_CH3_COM: J16.5; also elsewhere on the board
TIM4_CH4_COM: J16.6; also elsewhere on the board
UART2_RX_COM: J12.4; also elsewhere on the board
UART2_RX_NAV: J14.4; also elsewhere on the board
UART2_TX_COM: J12.3; also elsewhere on the board
UART2_TX_NAV: J14.3; also elsewhere on the board
UART3_RX_COM: R51.2; also elsewhere on the board
UART3_RX_NAV: R50.1; also elsewhere on the board
UART3_TX_COM: R50.2; also elsewhere on the board
UART3_TX_NAV: R51.1; also elsewhere on the board
UART4_RX_COM: J15.4; also elsewhere on the board
UART4_TX_COM: J15.3; also elsewhere on the board
WIFI_BUCVBATS: J9.1, J11.1, J12.1, J13.1, J14.1, J15.1, J16.1, R61.1; also elsewhere on the board

Notes on the sheet:
NAV Board to Wire (Molex PicoBlade)
SPI (NAV <-> COM)
UART (NAV <-> COM)
COM Board to Wire (Molex PicoBlade)
Connectors (Additional peripherals + Mounting + (NAV <-> COM))
Mounting Hole

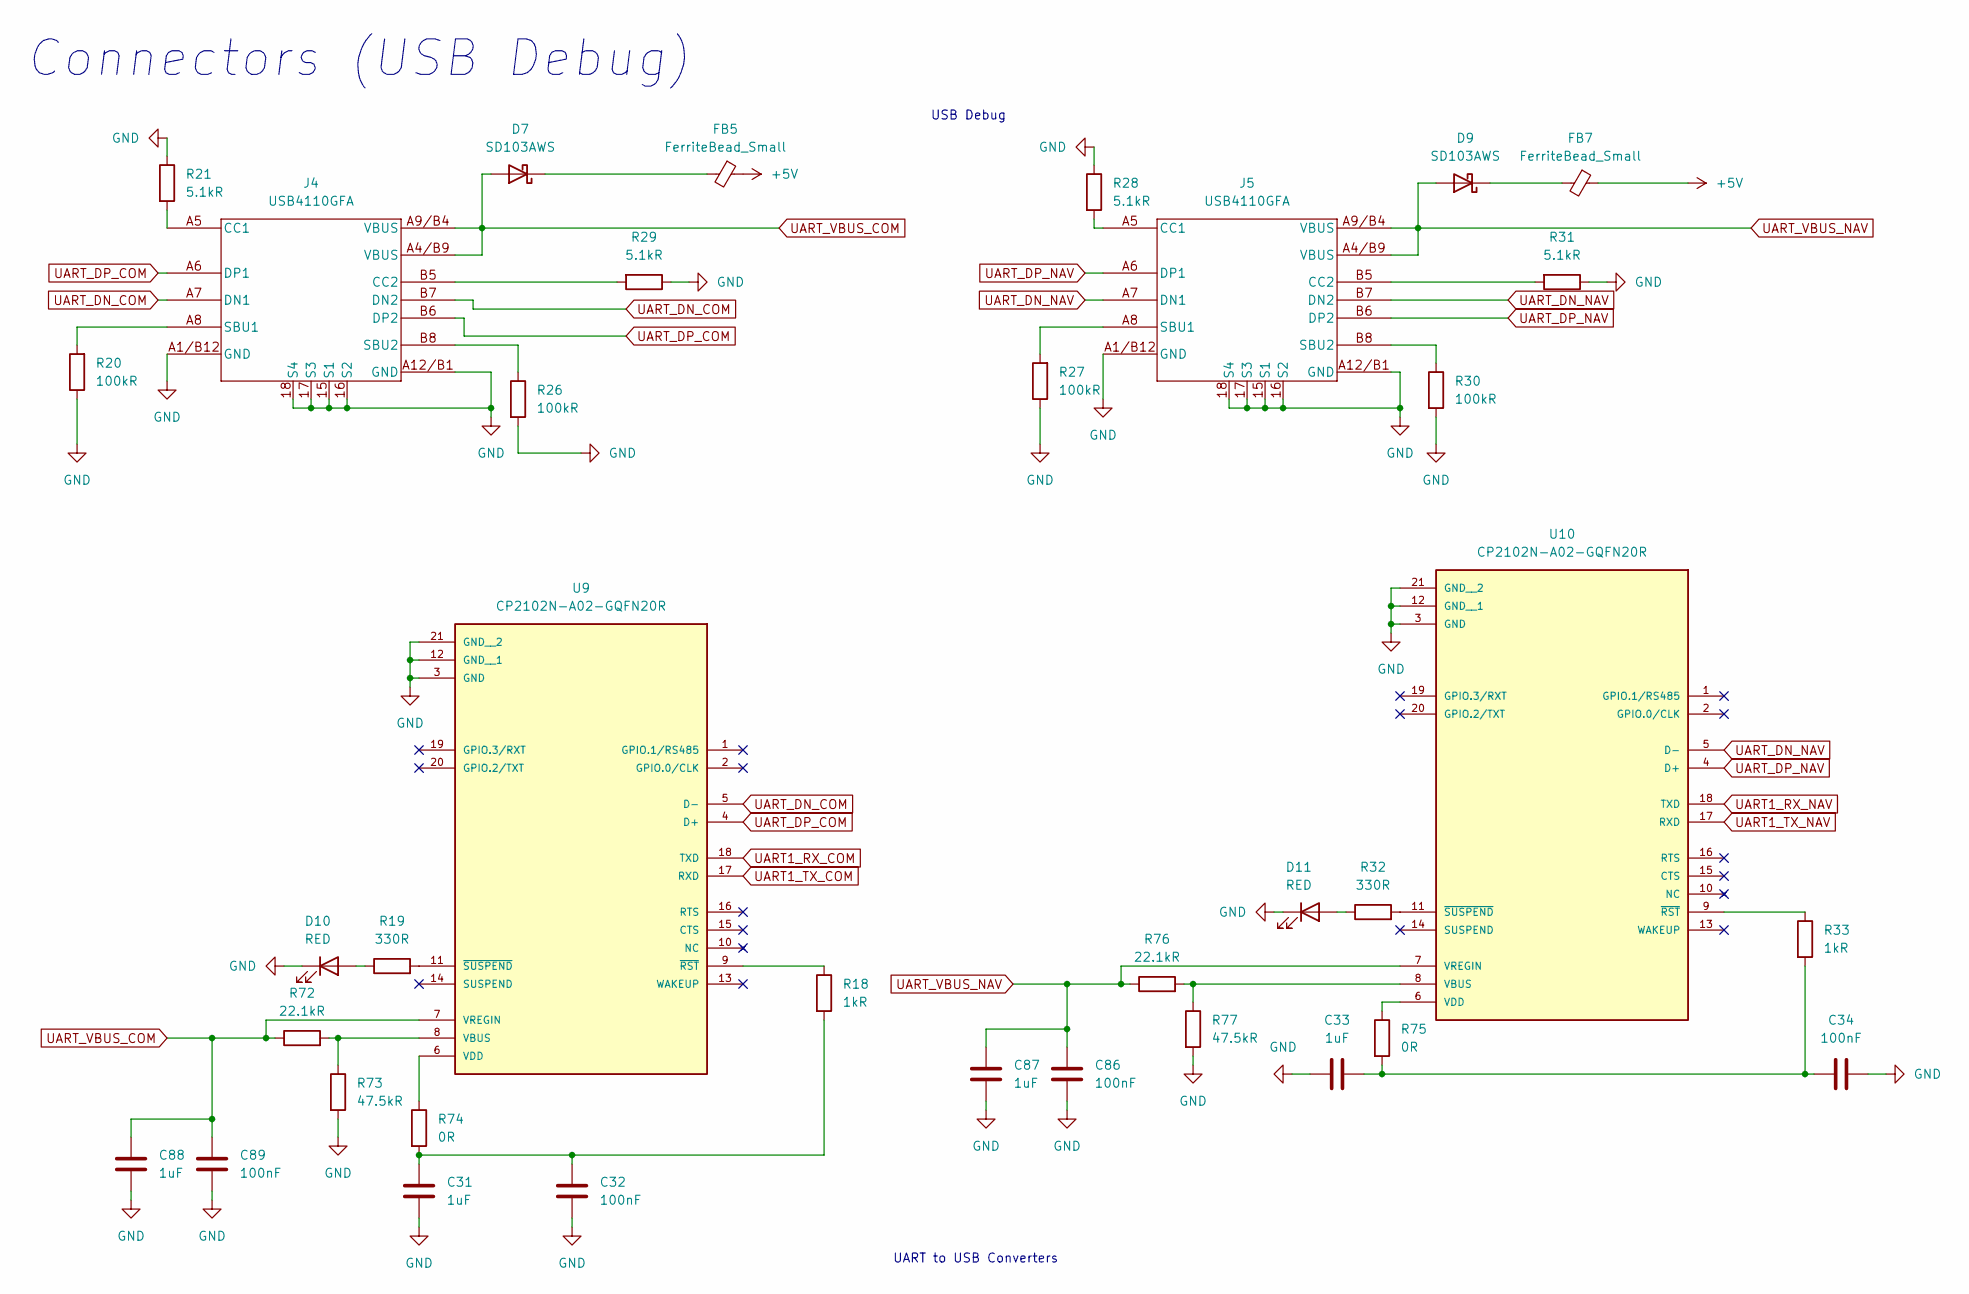
[picture p10: schematic Connections_2_sch.kicad_sch, Carte_Embarquée_CRAN_SEGULA]

Parts:
C31, C33, C87, C88: 1uF; CAPC17595_90N_KEM
C32, C34, C86, C89: 100nF; CAPC1005X55N
D7, D9: SD103AWS; D_SOD-323
D10, D11: RED; 599-0001-007F_DIA
FB5, FB7: FerriteBead_Small; L_0402_1005Metric
J4, J5: USB4110GFA; USB4110-GF-A_GCT
R18, R33: 1kR; RESC1005X40N
R19, R32: 330R; RES_ERJPA3D3300V
R20, R26, R27, R30: 100kR; RES_ERJ2RKF1003X
R21, R28, R29, R31: 5.1kR; RES_ERJ2RKF5101X
R72, R76: 22.1kR; RESC1005X40N
R73, R77: 47.5kR; RESC1005X40N
R74, R75: 0R; RESC1508X50N
U9, U10: CP2102N-A02-GQFN20R; QFN20_SIL; PARTREV 1.3

Connections:
+5V: FB5.1, FB7.1; also elsewhere on the board
GND: C31.2, C32.2, C33.2, C34.2, C86.2, C87.2, C88.2, C89.2, D10.1 (K), D11.1 (K), J4.15 (S1), J4.16 (S2), J4.17 (S3), J4.18 (S4), J4.A1/B12 (GND), J4.A12/B1 (GND), J5.15 (S1), J5.16 (S2), J5.17 (S3), J5.18 (S4), J5.A1/B12 (GND), J5.A12/B1 (GND), R20.1, R21.1, R26.2, R27.1, R28.1, R29.1, R30.2, R31.1, R73.2, R77.2, U9.3 (GND), U9.12 (GND__1), U9.21 (GND__2), U10.3 (GND), U10.12 (GND__1), U10.21 (GND__2); also elsewhere on the board
unnamed: C31.1, C32.1, R18.2, R74.2
unnamed: C33.1, C34.1, R33.2, R75.2
unnamed: D7.1 (K), FB5.2
unnamed: D9.1 (K), FB7.2
unnamed: D10.2 (A), R19.1
unnamed: D11.2 (A), R32.1
unnamed: J4.A5 (CC1), R21.2
unnamed: J4.B5 (CC2), R29.2
unnamed: J4.A8 (SBU1), R20.2
unnamed: J4.B8 (SBU2), R26.1
unnamed: J5.A5 (CC1), R28.2
unnamed: J5.B5 (CC2), R31.2
unnamed: J5.A8 (SBU1), R27.2
unnamed: J5.B8 (SBU2), R30.1
unnamed: R72.2, R73.1, U9.8 (VBUS)
unnamed: R74.1, U9.6 (VDD)
unnamed: R18.1, U9.9 (~RST)
unnamed: R19.2, U9.11 (~SUSPEND)
unnamed: R76.2, R77.1, U10.8 (VBUS)
unnamed: R75.1, U10.6 (VDD)
unnamed: R33.1, U10.9 (~RST)
unnamed: R32.2, U10.11 (~SUSPEND)
UART1_RX_COM: U9.18 (TXD); also elsewhere on the board
UART1_RX_NAV: U10.18 (TXD); also elsewhere on the board
UART1_TX_COM: U9.17 (RXD); also elsewhere on the board
UART1_TX_NAV: U10.17 (RXD); also elsewhere on the board
UART_DN_COM: J4.A7 (DN1), J4.B7 (DN2), U9.5 (D-)
UART_DN_NAV: J5.A7 (DN1), J5.B7 (DN2), U10.5 (D-)
UART_DP_COM: J4.A6 (DP1), J4.B6 (DP2), U9.4 (D+)
UART_DP_NAV: J5.A6 (DP1), J5.B6 (DP2), U10.4 (D+)
UART_VBUS_COM: C88.1, C89.1, D7.2 (A), J4.A4/B9 (VBUS), J4.A9/B4 (VBUS), R72.1, U9.7 (VREGIN)
UART_VBUS_NAV: C86.1, C87.1, D9.2 (A), J5.A4/B9 (VBUS), J5.A9/B4 (VBUS), R76.1, U10.7 (VREGIN)

Notes on the sheet:
UART to USB Converters
USB Debug
Connectors (USB Debug)

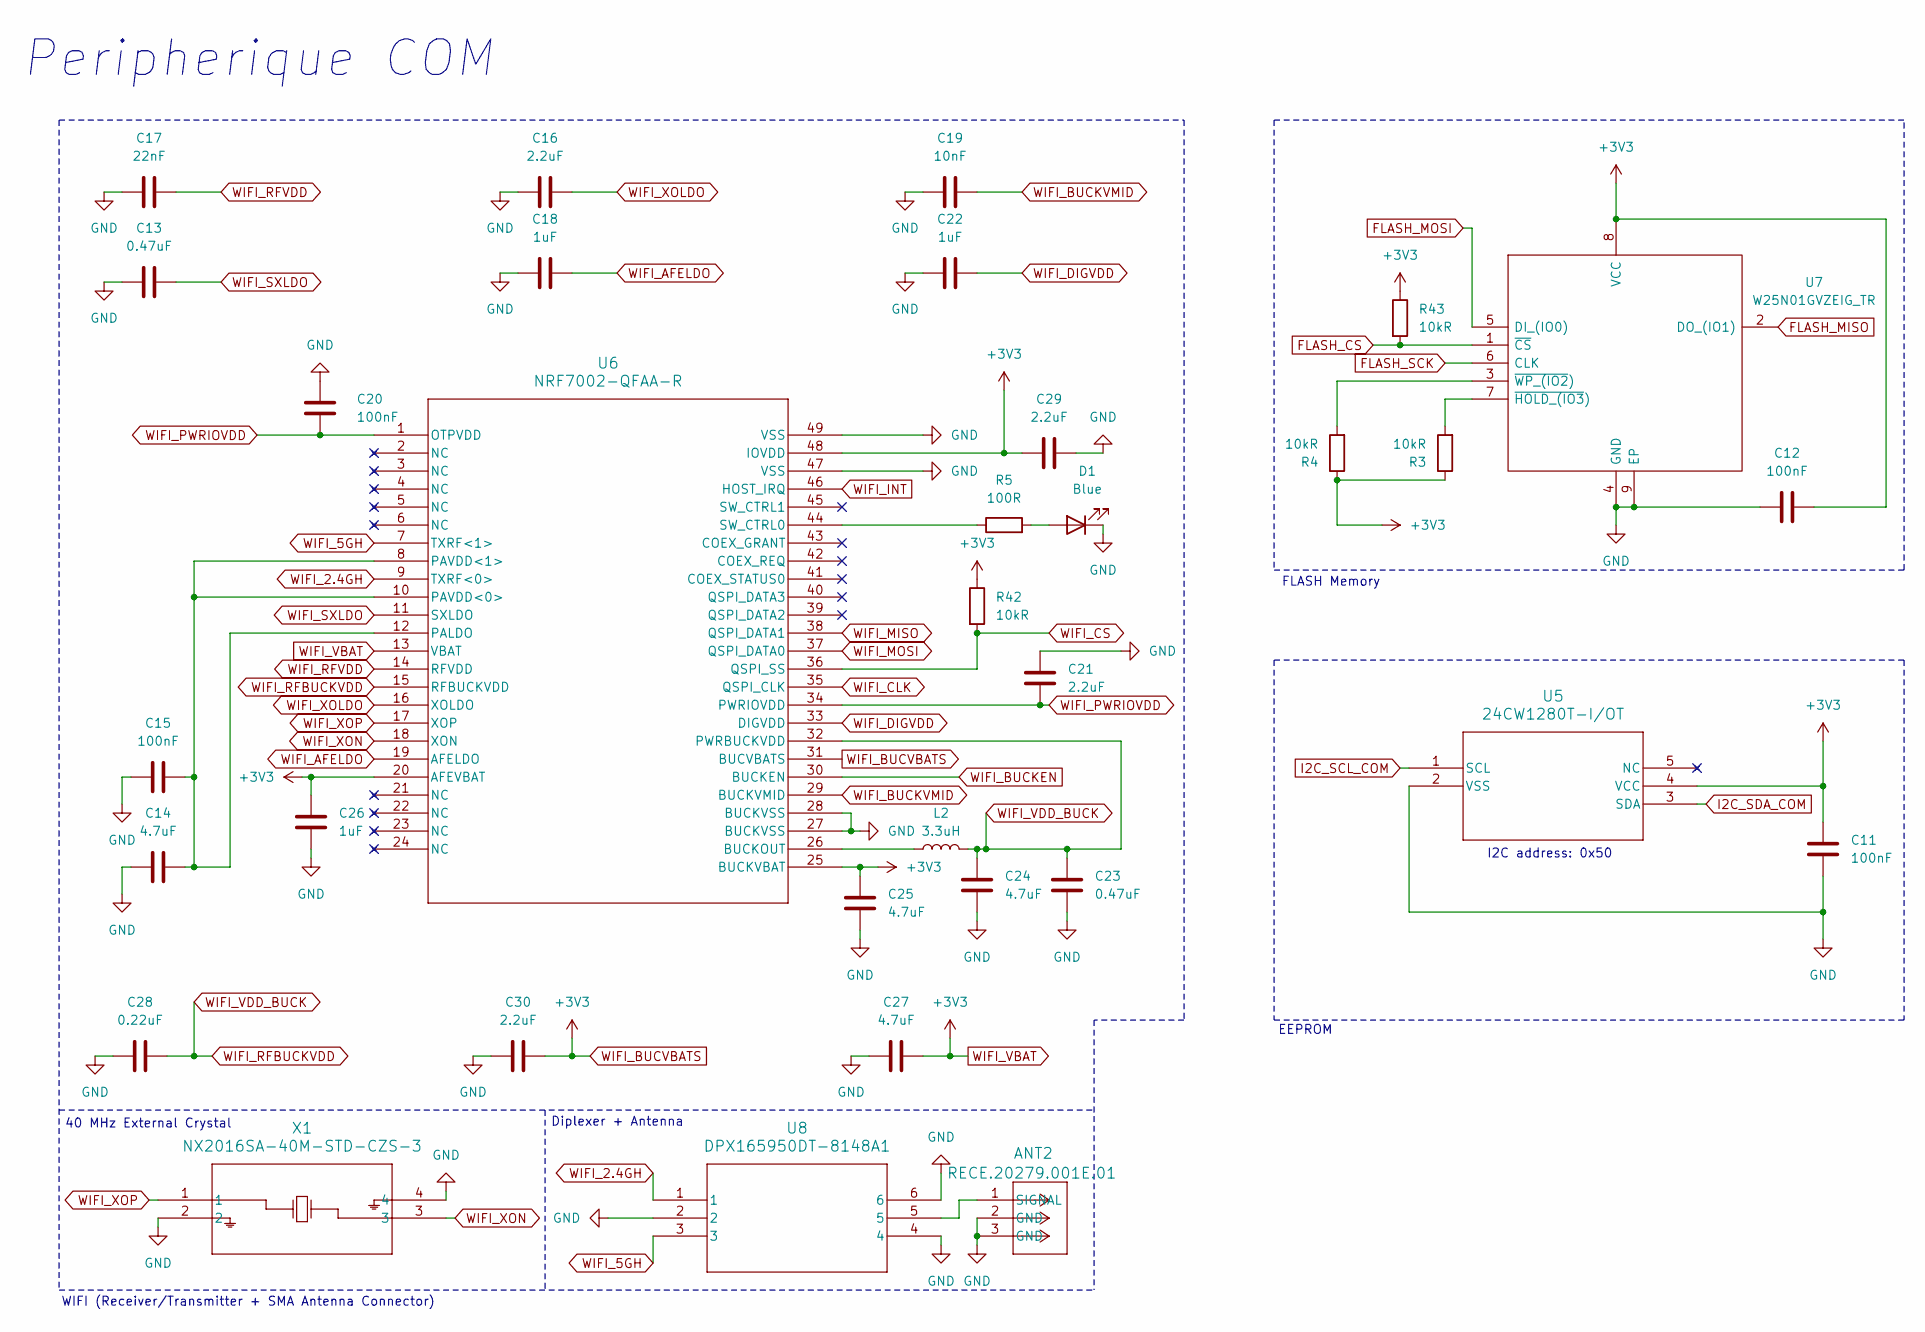
[picture p11: schematic Communication_Peripherique.kicad_sch, Carte_Embarquée_CRAN_SEGULA]

Parts:
ANT2: RECE.20279.001E.01; CON3_RECE.20279.001E.01_TAL
C11, C12: 100nF; CAPC1005X55N
C13, C23: 0.47uF; CAPC0603X33N
C14, C24, C25, C27: 4.7uF; CAPC1608X100N
C15, C20: 100nF; CAPC0603X33N
C16, C29, C30: 2.2uF; CAPC1608X100N
C17: 22nF; CAPC0603X33N
C18: 1uF; CAPC1005X70N
C19: 10nF; CAPC1005X55N
C21: 2.2uF; CAPC1005X70N
C22, C26: 1uF; CAPC1005X60N
C28: 0.22uF; CAPC0603X33N
D1: Blue; 599-0091-007F_DIA
L2: 3.3uH; WE-PMI_0805_H1
R3, R4, R42, R43: 10kR; RESC1105X40N
R5: 100R; RES_ERJPA3D1000V
U5: 24CW1280T-I/OT; SOT-23-5_2P9X1P6_MCH
U6: NRF7002-QFAA-R; QFN48_6X6_NOR
U7: W25N01GVZEIG_TR; SON127P800X600X80-9N-D; Manufacturer_Part_Number W25N01GVZEIG TR; Mouser Part Number 454-W25N01GVZEIGTR
U8: DPX165950DT-8148A1; RF_5049A1_TDK
X1: NX2016SA-40M-STD-CZS-3; NX2016SA-40M-STD-CZS-3_NDK

Connections:
FLASH_CS: R43.2, U7.1 (~CS); also elsewhere on the board
FLASH_MISO: U7.2 (DO_(IO1)); also elsewhere on the board
FLASH_MOSI: U7.5 (DI_(IO0)); also elsewhere on the board
FLASH_SCK: U7.6 (CLK); also elsewhere on the board
GND: ANT2.2 (GND), ANT2.3 (GND), C11.2, C12.1, C13.1, C14.2, C15.1, C16.1, C17.2, C18.1, C19.1, C20.1, C21.1, C22.1, C23.2, C24.2, C25.2, C26.1, C27.1, C28.1, C29.2, C30.1, D1.1 (K), U5.2 (VSS), U6.27 (BUCKVSS), U6.28 (BUCKVSS), U6.47 (VSS), U6.49 (VSS), U7.4 (GND), U7.9 (EP), U8.2, U8.4, U8.6, X1.2, X1.4; also elsewhere on the board
I2C_SCL_COM: U5.1 (SCL); also elsewhere on the board
I2C_SDA_COM: U5.3 (SDA); also elsewhere on the board
unnamed: ANT2.1 (SIGNAL), U8.5
unnamed: D1.2 (A), R5.2
unnamed: L2.1, U6.26 (BUCKOUT)
unnamed: C14.1, C15.2, U6.8 (PAVDD<1>), U6.10 (PAVDD<0>), U6.12 (PALDO)
unnamed: R5.1, U6.44 (SW_CTRL0)
unnamed: R3.2, U7.7 (~HOLD_(IO3))
unnamed: R4.2, U7.3 (~WP_(IO2))
WIFI_2.4GH: U6.9 (TXRF<0>), U8.1
WIFI_5GH: U6.7 (TXRF<1>), U8.3
WIFI_AFELDO: C18.2, U6.19 (AFELDO)
WIFI_BUCKEN: U6.30 (BUCKEN); also elsewhere on the board
WIFI_BUCKVMID: C19.2, U6.29 (BUCKVMID)
WIFI_BUCVBATS: C11.1, C12.2, C25.1, C26.2, C27.2, C29.1, C30.2, R3.1, R4.1, R42.1, R43.1, U5.4 (VCC), U6.13 (VBAT), U6.20 (AFEVBAT), U6.25 (BUCKVBAT), U6.31 (BUCVBATS), U6.48 (IOVDD), U7.8 (VCC); also elsewhere on the board
WIFI_CLK: U6.35 (QSPI_CLK); also elsewhere on the board
WIFI_CS: R42.2, U6.36 (QSPI_SS); also elsewhere on the board
WIFI_DIGVDD: C22.2, U6.33 (DIGVDD)
WIFI_INT: U6.46 (HOST_IRQ); also elsewhere on the board
WIFI_MISO: U6.38 (QSPI_DATA1); also elsewhere on the board
WIFI_MOSI: U6.37 (QSPI_DATA0); also elsewhere on the board
WIFI_PWRIOVDD: C20.2, C21.2, U6.1 (OTPVDD), U6.34 (PWRIOVDD)
WIFI_RFBUCKVDD: C23.1, C24.1, C28.2, L2.2, U6.15 (RFBUCKVDD), U6.32 (PWRBUCKVDD)
WIFI_RFVDD: C17.1, U6.14 (RFVDD)
WIFI_SXLDO: C13.2, U6.11 (SXLDO)
WIFI_XOLDO: C16.2, U6.16 (XOLDO)
WIFI_XON: U6.18 (XON), X1.3
WIFI_XOP: U6.17 (XOP), X1.1

Notes on the sheet:
40 MHz External Crystal
I2C address: 0x50
Diplexer + Antenna
Peripherique COM
FLASH Memory
WIFI (Receiver/Transmitter + SMA Antenna Connector)
EEPROM

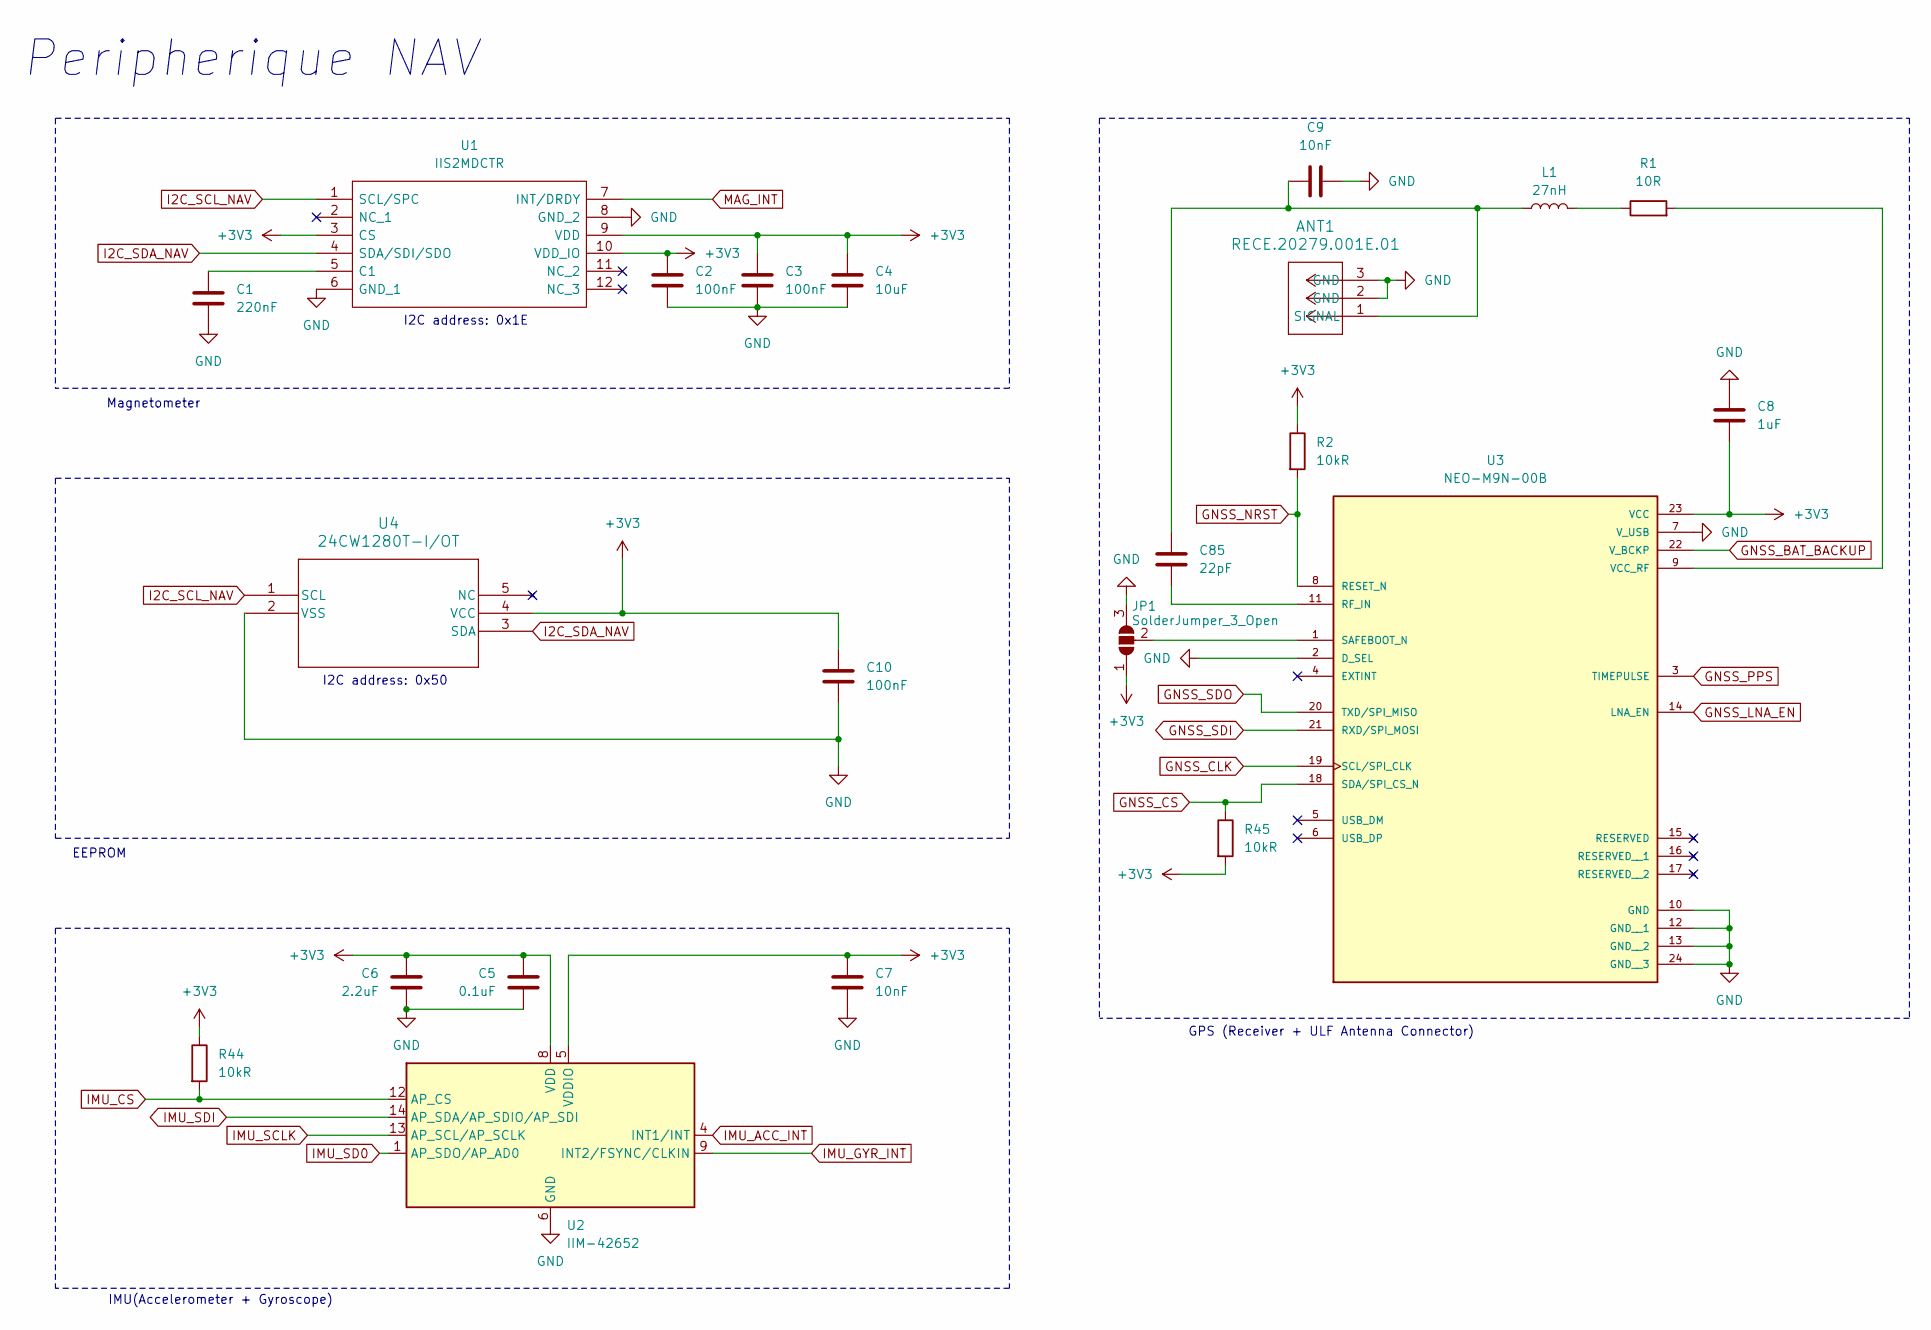
[picture p12: schematic Navigation_Peripherique.kicad_sch, Carte_Embarquée_CRAN_SEGULA]

Parts:
ANT1: RECE.20279.001E.01; CON3_RECE.20279.001E.01_TAL
C1: 220nF; CAPC17595_87N_KEM
C2, C3, C10: 100nF; CAPC1005X55N
C4: 10uF; CAPC1608X100N
C5: 0.1uF; CAPC1005X55N
C6: 2.2uF; CAPC1608X100N
C7, C9: 10nF; CAPC1005X55N
C8: 1uF; CAPC17595_90N_KEM
C85: 22pF; CAPC1005X55N
JP1: SolderJumper_3_Open; SolderJumper-3_P1.3mm_Open_RoundedPad1.0x1.5mm
L1: 27nH; INDC1006X60N
R1: 10R; RES_ERA2AKD100X
R2, R44, R45: 10kR; RESC1105X40N
U1: IIS2MDCTR; Manufacturer_Part_Number IIS2MDCTR; Mouser Part Number 511-IIS2MDCTR
U2: IIM-42652; Bosch_LGA-14_3x2.5mm_P0.5mm
U3: NEO-M9N-00B; XCVR_NEO-M9N-00B; PARTREV R05
U4: 24CW1280T-I/OT; SOT-23-5_2P9X1P6_MCH

Connections:
GND: ANT1.2 (GND), ANT1.3 (GND), C1.2, C2.2, C3.2, C4.2, C5.2, C6.2, C7.2, C8.1, C9.1, C10.2, JP1.3 (B), U1.6 (GND_1), U1.8 (GND_2), U2.6 (GND), U2.7 (GND), U3.2 (D_SEL), U3.7 (V_USB), U3.10 (GND), U3.12 (GND__1), U3.13 (GND__2), U3.24 (GND__3), U4.2 (VSS); also elsewhere on the board
GNSS_BAT_BACKUP: U3.22 (V_BCKP); also elsewhere on the board
GNSS_CLK: U3.19 (SCL/SPI_CLK); also elsewhere on the board
GNSS_CS: R45.1, U3.18 (SDA/SPI_CS_N); also elsewhere on the board
GNSS_LNA_EN: U3.14 (LNA_EN); also elsewhere on the board
GNSS_NRST: R2.2, U3.8 (RESET_N); also elsewhere on the board
GNSS_PPS: U3.3 (TIMEPULSE); also elsewhere on the board
GNSS_SDI: U3.21 (RXD/SPI_MOSI); also elsewhere on the board
GNSS_SDO: U3.20 (TXD/SPI_MISO); also elsewhere on the board
I2C_SCL_NAV: U1.1 (SCL/SPC), U4.1 (SCL); also elsewhere on the board
I2C_SDA_NAV: U1.4 (SDA/SDI/SDO), U4.3 (SDA); also elsewhere on the board
IMU_ACC_INT: U2.4 (INT1/INT); also elsewhere on the board
IMU_CS: R44.2, U2.12 (AP_CS); also elsewhere on the board
IMU_GYR_INT: U2.9 (INT2/FSYNC/CLKIN); also elsewhere on the board
IMU_SCLK: U2.13 (AP_SCL/AP_SCLK); also elsewhere on the board
IMU_SD0: U2.1 (AP_SDO/AP_AD0); also elsewhere on the board
IMU_SDI: U2.14 (AP_SDA/AP_SDIO/AP_SDI); also elsewhere on the board
MAG_INT: U1.7 (INT/DRDY); also elsewhere on the board
unnamed: ANT1.1 (SIGNAL), C9.2, C85.1, L1.1
unnamed: JP1.2 (C), U3.1 (SAFEBOOT_N)
unnamed: L1.2, R1.1
unnamed: C1.1, U1.5 (C1)
unnamed: C85.2, U3.11 (RF_IN)
unnamed: R1.2, U3.9 (VCC_RF)
WIFI_BUCVBATS: C2.1, C3.1, C4.1, C5.1, C6.1, C7.1, C8.2, C10.1, JP1.1 (A), R2.1, R44.1, R45.2, U1.3 (CS), U1.9 (VDD), U1.10 (VDD_IO), U2.5 (VDDIO), U2.8 (VDD), U3.23 (VCC), U4.4 (VCC); also elsewhere on the board

Notes on the sheet:
Peripherique NAV
I2C address: 0x1E
I2C address: 0x50
Magnetometer
IMU(Accelerometer + Gyroscope)
GPS (Receiver + ULF Antenna Connector)
EEPROM
