kslhuy/CartePCB/Card_CRAN_SEGULA/Card_CRAN_SEGULA.kicad_pcb

## KiCad design Card_CRAN_SEGULA/Card_CRAN_SEGULA.kicad_pcb (continued)

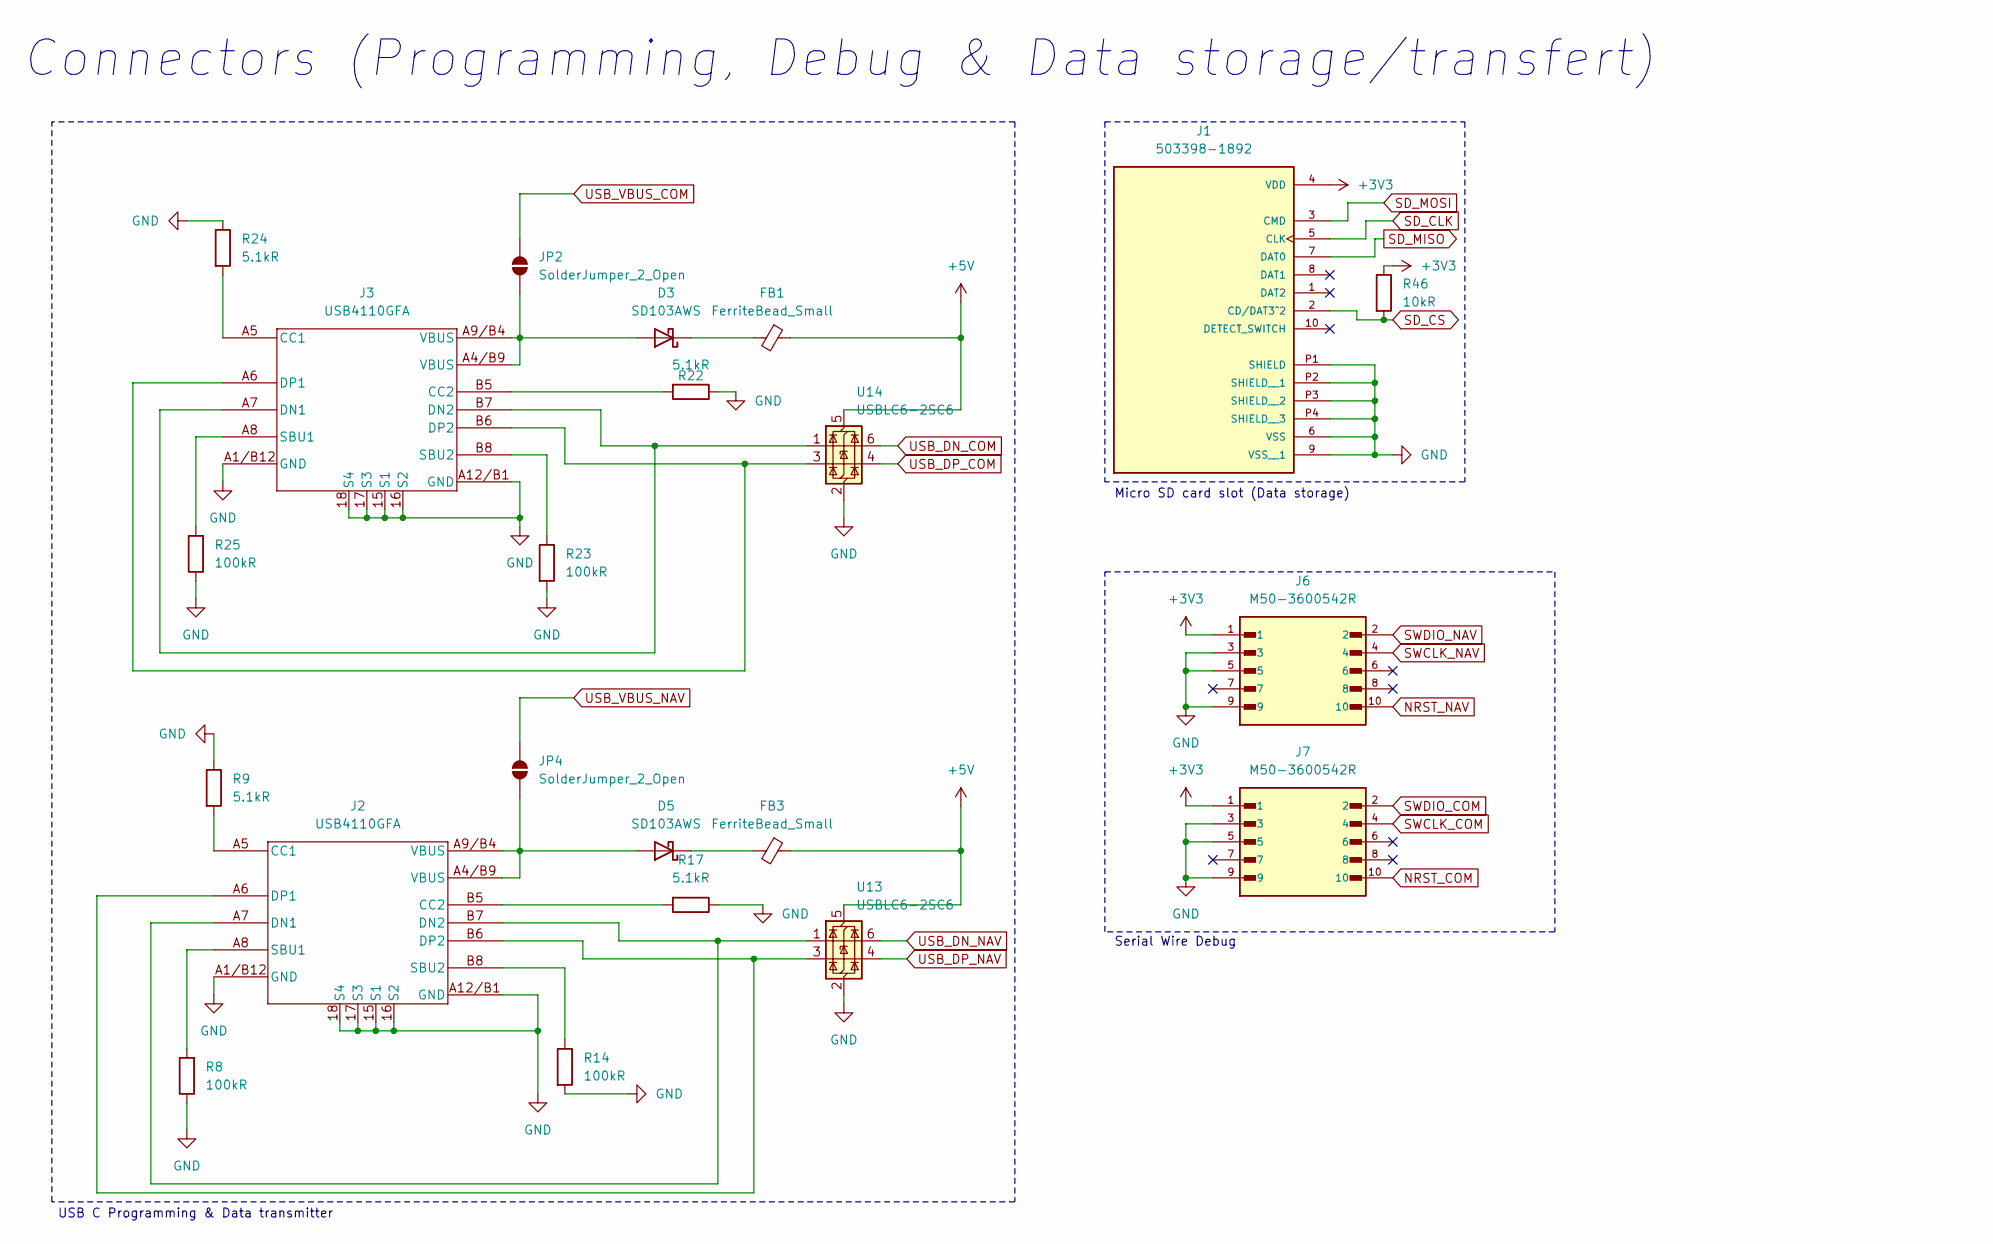
[picture p13: schematic Connections.kicad_sch, Carte_Embarquée_CRAN_SEGULA]

Parts:
D3, D5: SD103AWS; D_SOD-323
FB1, FB3: FerriteBead_Small; L_0402_1005Metric
J1: 503398-1892; MOLEX_503398-1892; PARTREV 0
J2, J3: USB4110GFA; USB4110-GF-A_GCT
J6, J7: M50-3600542R; HARWIN_M50-3600542R
JP2, JP4: SolderJumper_2_Open; SolderJumper-2_P1.3mm_Open_RoundedPad1.0x1.5mm
R8, R14, R23, R25: 100kR; RES_ERJ2RKF1003X
R9, R17, R22, R24: 5.1kR; RES_ERJ2RKF5101X
R46: 10kR; RESC1105X40N
U13, U14: USBLC6-2SC6; SOT-23-6

Connections:
+5V: FB1.1, FB3.1, U13.5 (VBUS), U14.5 (VBUS); also elsewhere on the board
GND: J1.6 (VSS), J1.9 (VSS__1), J1.P1 (SHIELD), J1.P2 (SHIELD__1), J1.P3 (SHIELD__2), J1.P4 (SHIELD__3), J2.15 (S1), J2.16 (S2), J2.17 (S3), J2.18 (S4), J2.A1/B12 (GND), J2.A12/B1 (GND), J3.15 (S1), J3.16 (S2), J3.17 (S3), J3.18 (S4), J3.A1/B12 (GND), J3.A12/B1 (GND), J6.3, J6.5, J6.9, J7.3, J7.5, J7.9, R8.1, R9.1, R14.2, R17.1, R22.1, R23.2, R24.1, R25.1, U13.2 (GND), U14.2 (GND); also elsewhere on the board
NRST_COM: J7.10; also elsewhere on the board
NRST_NAV: J6.10; also elsewhere on the board
unnamed: D3.2 (A), J3.A4/B9 (VBUS), J3.A9/B4 (VBUS), JP2.1 (A)
unnamed: D3.1 (K), FB1.2
unnamed: D5.2 (A), J2.A4/B9 (VBUS), J2.A9/B4 (VBUS), JP4.1 (A)
unnamed: D5.1 (K), FB3.2
unnamed: J2.A5 (CC1), R9.2
unnamed: J2.B5 (CC2), R17.2
unnamed: J2.A7 (DN1), J2.B7 (DN2), U13.1 (I/O1)
unnamed: J2.A6 (DP1), J2.B6 (DP2), U13.3 (I/O2)
unnamed: J2.A8 (SBU1), R8.2
unnamed: J2.B8 (SBU2), R14.1
unnamed: J3.A5 (CC1), R24.2
unnamed: J3.B5 (CC2), R22.2
unnamed: J3.A7 (DN1), J3.B7 (DN2), U14.1 (I/O1)
unnamed: J3.A6 (DP1), J3.B6 (DP2), U14.3 (I/O2)
unnamed: J3.A8 (SBU1), R25.2
unnamed: J3.B8 (SBU2), R23.1
SD_CLK: J1.5 (CLK); also elsewhere on the board
SD_CS: J1.2 (CD/DAT3^2), R46.2; also elsewhere on the board
SD_MISO: J1.7 (DAT0); also elsewhere on the board
SD_MOSI: J1.3 (CMD); also elsewhere on the board
SWCLK_COM: J7.4; also elsewhere on the board
SWCLK_NAV: J6.4; also elsewhere on the board
SWDIO_COM: J7.2; also elsewhere on the board
SWDIO_NAV: J6.2; also elsewhere on the board
USB_DN_COM: U14.6 (I/O1); also elsewhere on the board
USB_DN_NAV: U13.6 (I/O1); also elsewhere on the board
USB_DP_COM: U14.4 (I/O2); also elsewhere on the board
USB_DP_NAV: U13.4 (I/O2); also elsewhere on the board
USB_VBUS_COM: JP2.2 (B); also elsewhere on the board
USB_VBUS_NAV: JP4.2 (B); also elsewhere on the board
WIFI_BUCVBATS: J1.4 (VDD), J6.1, J7.1, R46.1; also elsewhere on the board

Notes on the sheet:
Connectors (Programming, Debug & Data storage/transfert)
Micro SD card slot (Data storage)
USB C Programming & Data transmitter
Serial Wire Debug

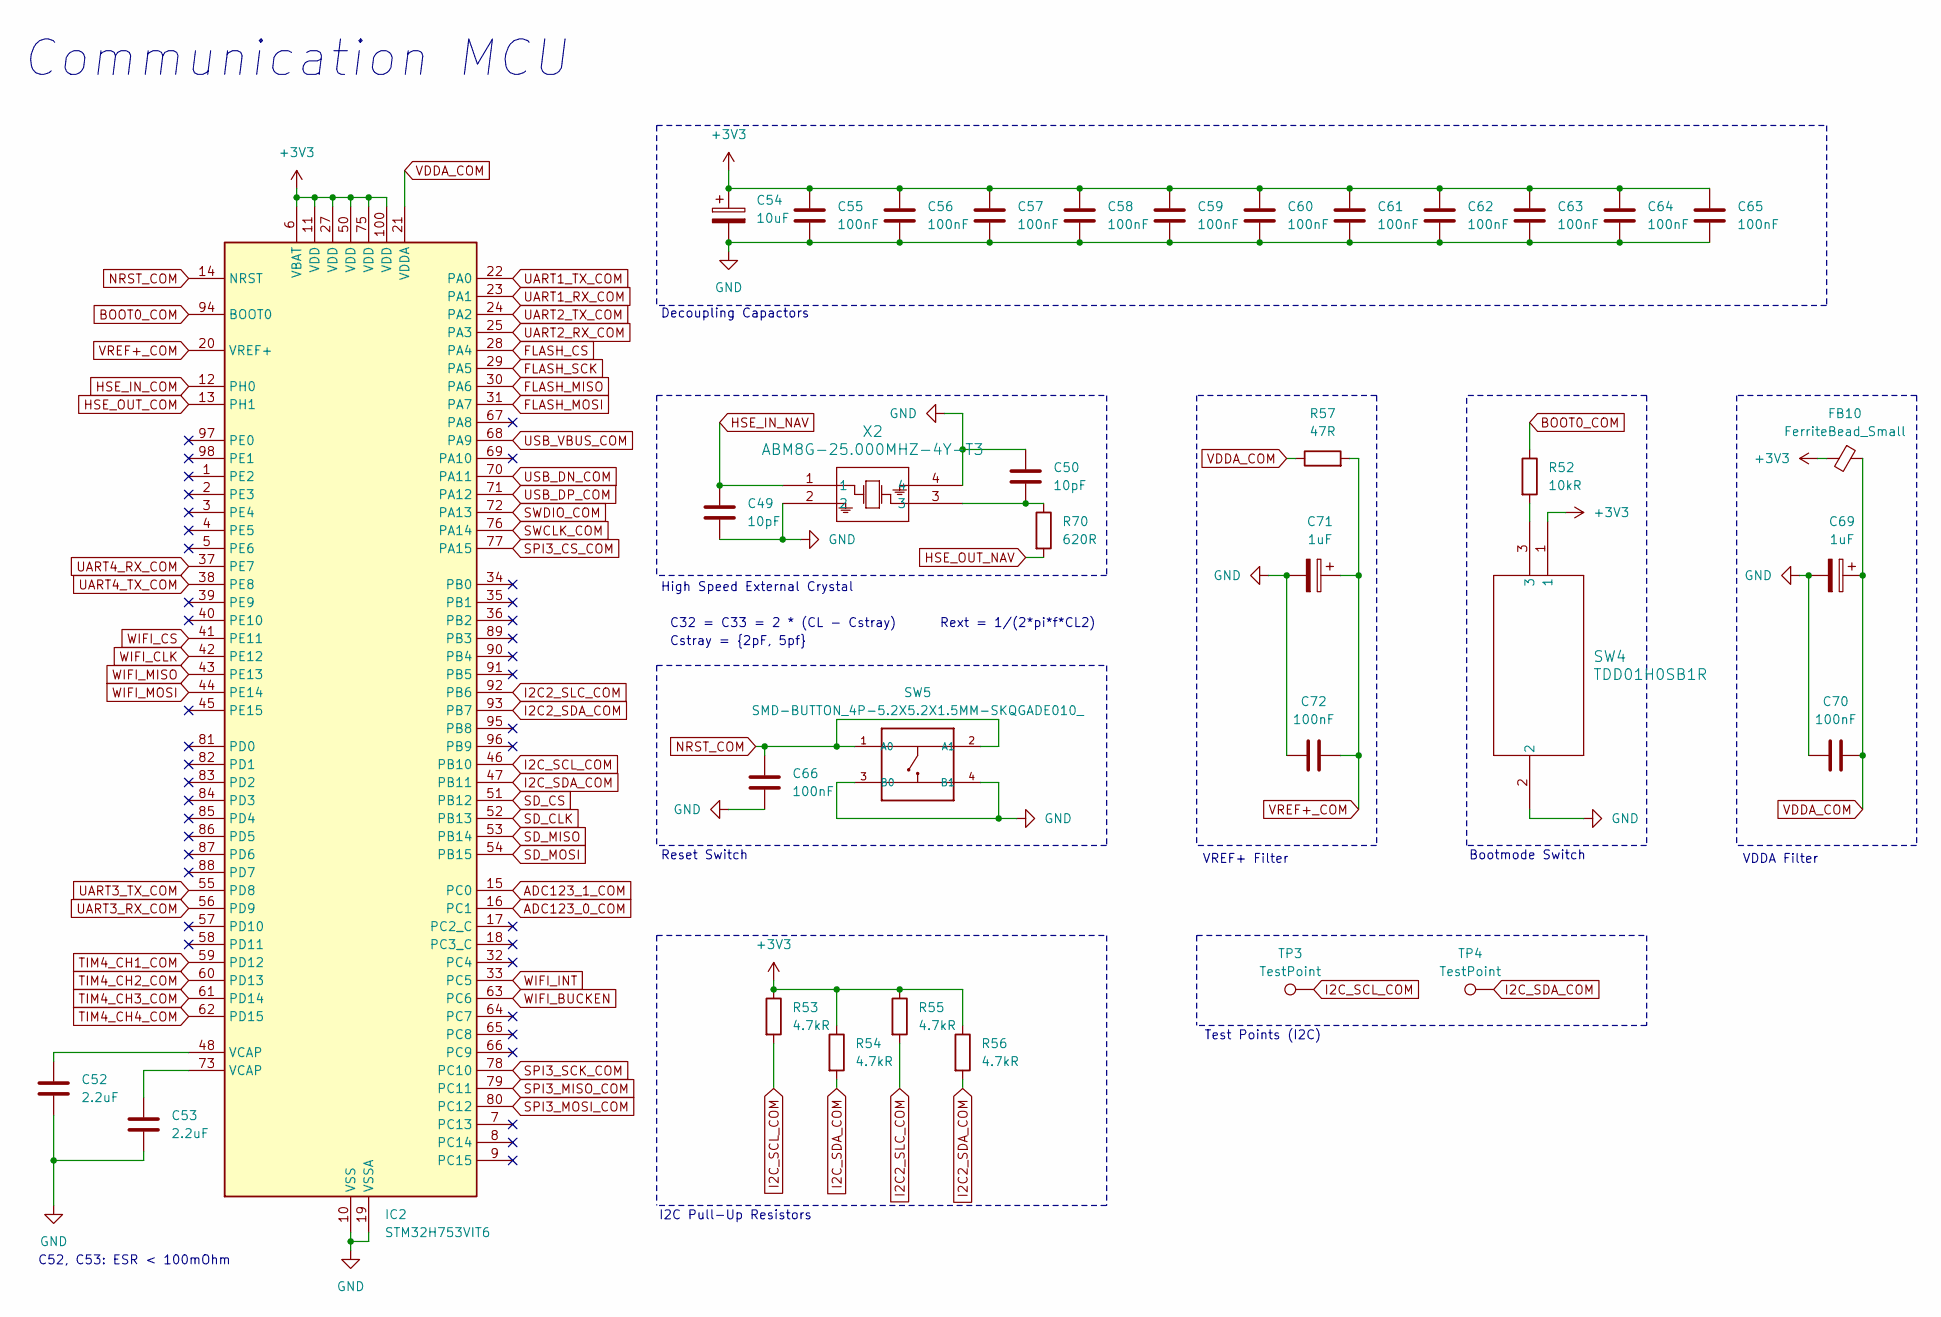
[picture p14: schematic MCU_Communication.kicad_sch, Carte_Embarquée_CRAN_SEGULA]

Parts:
C49, C50: 10pF; CAP_0402C_AVX
C52, C53: 2.2uF; CAPC1608X100N
C54: 10uF; CAPMP2.1X1.25_1N_KEM
C55, C56, C57, C58, C59, C60, C61, C62, C63, C64, C65, C66, C70, C72: 100nF; CAPC1005X55N
C69, C71: 1uF; TACL_AVX
FB10: FerriteBead_Small; L_0402_1005Metric
IC2: STM32H753VIT6; LQFP-100_14x14mm_P0.5mm
R52: 10kR; RESC1105X40N
R53, R54, R55, R56: 4.7kR; RESC1005X40N
R57: 47R; RES_ERA2AED470X
R70: 620R; RES_ERJPA3F6200V
SW4: TDD01H0SB1R; SOT_TDDSB1R_CNK
SW5: SMD-BUTTON_4P-5.2X5.2X1.5MM-SKQGADE010_; SW4-SMD-5.2X5.2X1.5MM
TP3, TP4: TestPoint; TestPoint_Pad_D1.5mm
X2: ABM8G-25.000MHZ-4Y-T3; ABM8G_ABR

Connections:
ADC123_0_COM: IC2.16 (PC1); also elsewhere on the board
ADC123_1_COM: IC2.15 (PC0); also elsewhere on the board
BOOT0_COM: IC2.94 (BOOT0), R52.1
FLASH_CS: IC2.28 (PA4); also elsewhere on the board
FLASH_MISO: IC2.30 (PA6); also elsewhere on the board
FLASH_MOSI: IC2.31 (PA7); also elsewhere on the board
FLASH_SCK: IC2.29 (PA5); also elsewhere on the board
GND: C49.2, C50.1, C52.2, C53.2, C54.2, C55.2, C56.2, C57.2, C58.2, C59.2, C60.2, C61.2, C62.2, C63.2, C64.2, C65.2, C66.2, C69.2, C70.1, C71.2, C72.1, IC2.10 (VSS), IC2.19 (VSSA), IC2.26 (VSS), IC2.49 (VSS), IC2.74 (VSS), IC2.99 (VSS), SW4.2, SW5.3 (B0), SW5.4 (B1), X2.2, X2.4; also elsewhere on the board
HSE_IN_COM: IC2.12 (PH0); also elsewhere on the board
HSE_IN_NAV: C49.1, X2.1; also elsewhere on the board
HSE_OUT_COM: IC2.13 (PH1); also elsewhere on the board
HSE_OUT_NAV: R70.2; also elsewhere on the board
I2C2_SDA_COM: IC2.93 (PB7), R56.2; also elsewhere on the board
I2C2_SLC_COM: IC2.92 (PB6), R55.2; also elsewhere on the board
I2C_SCL_COM: IC2.46 (PB10), R53.2, TP3.1; also elsewhere on the board
I2C_SDA_COM: IC2.47 (PB11), R54.2, TP4.1; also elsewhere on the board
NRST_COM: C66.1, IC2.14 (NRST), SW5.1 (A0), SW5.2 (A1); also elsewhere on the board
unnamed: C50.2, R70.1, X2.3
unnamed: C52.1, IC2.48 (VCAP)
unnamed: C53.1, IC2.73 (VCAP)
unnamed: R52.2, SW4.3
SD_CLK: IC2.52 (PB13); also elsewhere on the board
SD_CS: IC2.51 (PB12); also elsewhere on the board
SD_MISO: IC2.53 (PB14); also elsewhere on the board
SD_MOSI: IC2.54 (PB15); also elsewhere on the board
SPI3_CS_COM: IC2.77 (PA15); also elsewhere on the board
SWCLK_COM: IC2.76 (PA14); also elsewhere on the board
SWDIO_COM: IC2.72 (PA13); also elsewhere on the board
TIM4_CH1_COM: IC2.59 (PD12); also elsewhere on the board
TIM4_CH2_COM: IC2.60 (PD13); also elsewhere on the board
TIM4_CH3_COM: IC2.61 (PD14); also elsewhere on the board
TIM4_CH4_COM: IC2.62 (PD15); also elsewhere on the board
UART1_RX_COM: IC2.23 (PA1); also elsewhere on the board
UART1_TX_COM: IC2.22 (PA0); also elsewhere on the board
UART2_RX_COM: IC2.25 (PA3); also elsewhere on the board
UART2_TX_COM: IC2.24 (PA2); also elsewhere on the board
UART3_RX_COM: IC2.56 (PD9); also elsewhere on the board
UART3_TX_COM: IC2.55 (PD8); also elsewhere on the board
UART4_RX_COM: IC2.37 (PE7); also elsewhere on the board
UART4_TX_COM: IC2.38 (PE8); also elsewhere on the board
USB_DN_COM: IC2.70 (PA11); also elsewhere on the board
USB_DP_COM: IC2.71 (PA12); also elsewhere on the board
USB_VBUS_COM: IC2.68 (PA9); also elsewhere on the board
VDDA_COM: C69.1, C70.2, FB10.1, IC2.21 (VDDA), R57.1
VREF+_COM: C71.1, C72.2, IC2.20 (VREF+), R57.2
WIFI_BUCKEN: IC2.63 (PC6); also elsewhere on the board
WIFI_BUCVBATS: C54.1, C55.1, C56.1, C57.1, C58.1, C59.1, C60.1, C61.1, C62.1, C63.1, C64.1, C65.1, FB10.2, IC2.6 (VBAT), IC2.11 (VDD), IC2.27 (VDD), IC2.50 (VDD), IC2.75 (VDD), IC2.100 (VDD), R53.1, R54.1, R55.1, R56.1, SW4.1; also elsewhere on the board
WIFI_CLK: IC2.42 (PE12); also elsewhere on the board
WIFI_CS: IC2.41 (PE11); also elsewhere on the board
WIFI_INT: IC2.33 (PC5); also elsewhere on the board
WIFI_MISO: IC2.43 (PE13); also elsewhere on the board
WIFI_MOSI: IC2.44 (PE14); also elsewhere on the board

Notes on the sheet:
Test Points (I2C)
Decoupling Capactors
C52, C53: ESR < 100mOhm
High Speed External Crystal
Communication MCU
C32 = C33 = 2 * (CL - Cstray)
Rext = 1/(2*pi*f*CL2)
Reset Switch
Cstray = {2pF, 5pf}
Bootmode Switch
VREF+ Filter
I2C Pull-Up Resistors
VDDA Filter

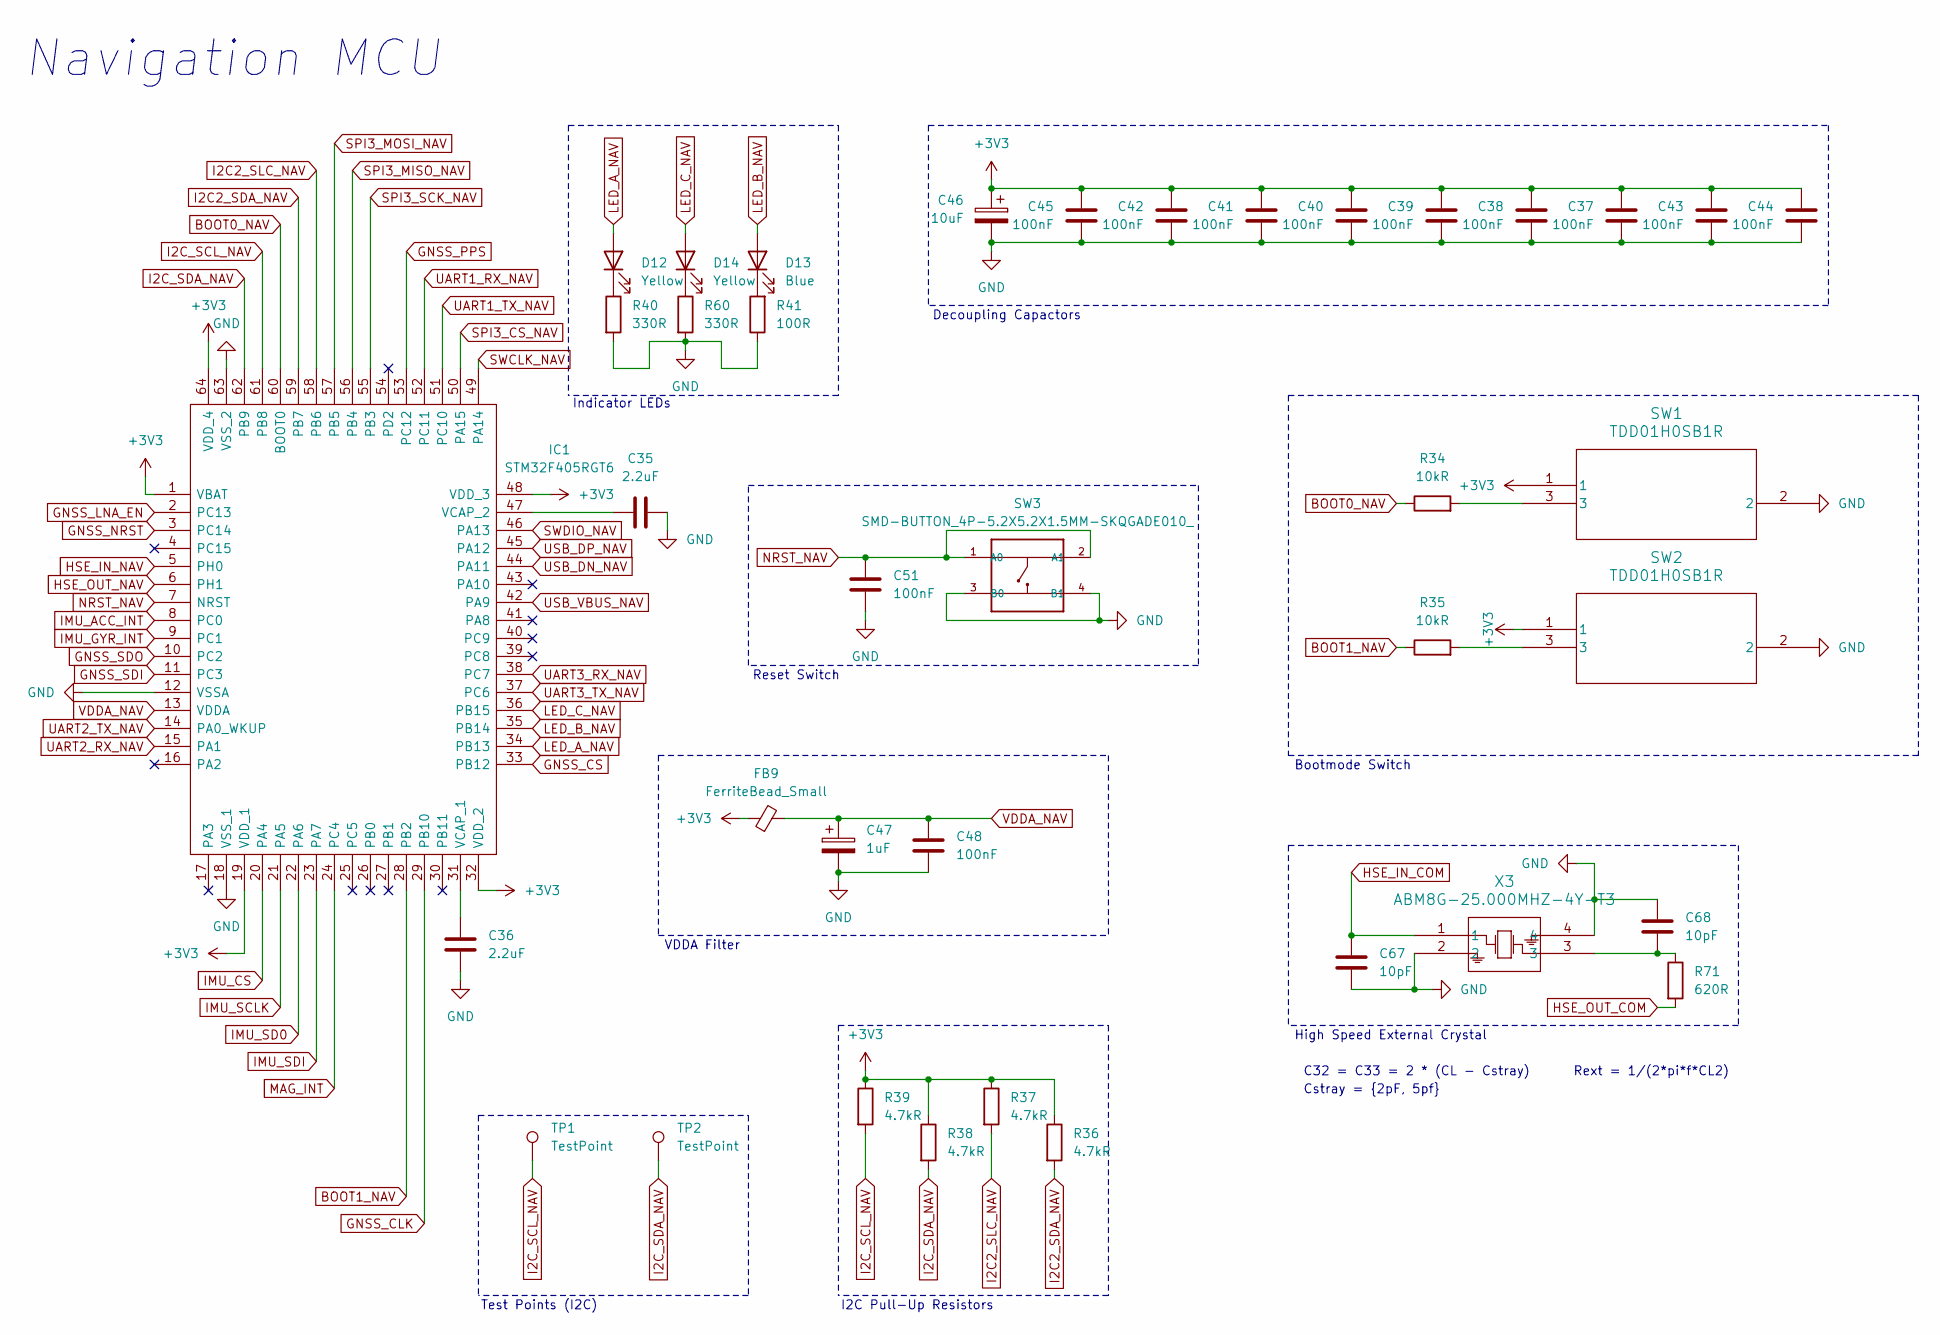
[picture p15: schematic MCU_Navigation.kicad_sch, Carte_Embarquée_CRAN_SEGULA]

Parts:
C35, C36: 2.2uF; CAPC1608X100N
C37, C38, C39, C40, C41, C42, C43, C44, C45, C48, C51: 100nF; CAPC1005X55N
C46: 10uF; CAPMP2.1X1.25_1N_KEM
C47: 1uF; TACL_AVX
C67, C68: 10pF; CAP_0402C_AVX
D12, D14: Yellow; 599-0004-007F_DIA
D13: Blue; 599-0091-007F_DIA
FB9: FerriteBead_Small; L_0402_1005Metric
IC1: STM32F405RGT6; QFP50P1200X1200X160-64N; Manufacturer_Part_Number STM32F405RGT6; Mouser Part Number 511-STM32F405RGT6
R34, R35: 10kR; RESC1105X40N
R36, R37, R38, R39: 4.7kR; RESC1005X40N
R40, R60: 330R; RES_ERJPA3D3300V
R41: 100R; RES_ERJPA3D1000V
R71: 620R; RES_ERJPA3F6200V
SW1, SW2: TDD01H0SB1R; SOT_TDDSB1R_CNK
SW3: SMD-BUTTON_4P-5.2X5.2X1.5MM-SKQGADE010_; SW4-SMD-5.2X5.2X1.5MM
TP1, TP2: TestPoint; TestPoint_Pad_D1.5mm
X3: ABM8G-25.000MHZ-4Y-T3; ABM8G_ABR

Connections:
BOOT0_NAV: IC1.60 (BOOT0), R34.1
BOOT1_NAV: IC1.28 (PB2), R35.1
GND: C35.2, C36.2, C37.2, C38.2, C39.2, C40.2, C41.2, C42.2, C43.2, C44.2, C45.2, C46.2, C47.2, C48.2, C51.2, C67.2, C68.1, IC1.12 (VSSA), IC1.18 (VSS_1), IC1.63 (VSS_2), R40.2, R41.1, R60.2, SW1.2, SW2.2, SW3.3 (B0), SW3.4 (B1), X3.2, X3.4; also elsewhere on the board
GNSS_CLK: IC1.29 (PB10); also elsewhere on the board
GNSS_CS: IC1.33 (PB12); also elsewhere on the board
GNSS_LNA_EN: IC1.2 (PC13); also elsewhere on the board
GNSS_NRST: IC1.3 (PC14); also elsewhere on the board
GNSS_PPS: IC1.53 (PC12); also elsewhere on the board
GNSS_SDI: IC1.11 (PC3); also elsewhere on the board
GNSS_SDO: IC1.10 (PC2); also elsewhere on the board
HSE_IN_COM: C67.1, X3.1; also elsewhere on the board
HSE_IN_NAV: IC1.5 (PH0); also elsewhere on the board
HSE_OUT_COM: R71.2; also elsewhere on the board
HSE_OUT_NAV: IC1.6 (PH1); also elsewhere on the board
I2C2_SDA_NAV: IC1.59 (PB7), R36.2; also elsewhere on the board
I2C2_SLC_NAV: IC1.58 (PB6), R37.2; also elsewhere on the board
I2C_SCL_NAV: IC1.61 (PB8), R39.2, TP1.1; also elsewhere on the board
I2C_SDA_NAV: IC1.62 (PB9), R38.2, TP2.1; also elsewhere on the board
IMU_ACC_INT: IC1.8 (PC0); also elsewhere on the board
IMU_CS: IC1.20 (PA4); also elsewhere on the board
IMU_GYR_INT: IC1.9 (PC1); also elsewhere on the board
IMU_SCLK: IC1.21 (PA5); also elsewhere on the board
IMU_SD0: IC1.22 (PA6); also elsewhere on the board
IMU_SDI: IC1.23 (PA7); also elsewhere on the board
LED_A_NAV: D12.2 (A), IC1.34 (PB13)
LED_B_NAV: D13.2 (A), IC1.35 (PB14)
LED_C_NAV: D14.2 (A), IC1.36 (PB15)
MAG_INT: IC1.24 (PC4); also elsewhere on the board
NRST_NAV: C51.1, IC1.7 (NRST), SW3.1 (A0), SW3.2 (A1); also elsewhere on the board
unnamed: C68.2, R71.1, X3.3
unnamed: D12.1 (K), R40.1
unnamed: D13.1 (K), R41.2
unnamed: D14.1 (K), R60.1
unnamed: C36.1, IC1.31 (VCAP_1)
unnamed: C35.1, IC1.47 (VCAP_2)
unnamed: R34.2, SW1.3
unnamed: R35.2, SW2.3
SPI3_CS_COM: IC1.50 (PA15); also elsewhere on the board
SWCLK_NAV: IC1.49 (PA14); also elsewhere on the board
SWDIO_NAV: IC1.46 (PA13); also elsewhere on the board
UART1_RX_NAV: IC1.52 (PC11); also elsewhere on the board
UART1_TX_NAV: IC1.51 (PC10); also elsewhere on the board
UART2_RX_NAV: IC1.15 (PA1); also elsewhere on the board
UART2_TX_NAV: IC1.14 (PA0_WKUP); also elsewhere on the board
UART3_RX_NAV: IC1.38 (PC7); also elsewhere on the board
UART3_TX_NAV: IC1.37 (PC6); also elsewhere on the board
USB_DN_NAV: IC1.44 (PA11); also elsewhere on the board
USB_DP_NAV: IC1.45 (PA12); also elsewhere on the board
USB_VBUS_NAV: IC1.42 (PA9); also elsewhere on the board
VDDA_NAV: C47.1, C48.1, FB9.2, IC1.13 (VDDA)
WIFI_BUCVBATS: C37.1, C38.1, C39.1, C40.1, C41.1, C42.1, C43.1, C44.1, C45.1, C46.1, FB9.1, IC1.1 (VBAT), IC1.19 (VDD_1), IC1.32 (VDD_2), IC1.48 (VDD_3), IC1.64 (VDD_4), R36.1, R37.1, R38.1, R39.1, SW1.1, SW2.1; also elsewhere on the board

Notes on the sheet:
VDDA Filter
Navigation MCU
Bootmode Switch
I2C Pull-Up Resistors
High Speed External Crystal
Cstray = {2pF, 5pf}
Test Points (I2C)
Reset Switch
Rext = 1/(2*pi*f*CL2)
Decoupling Capactors
C32 = C33 = 2 * (CL - Cstray)
Indicator LEDs

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
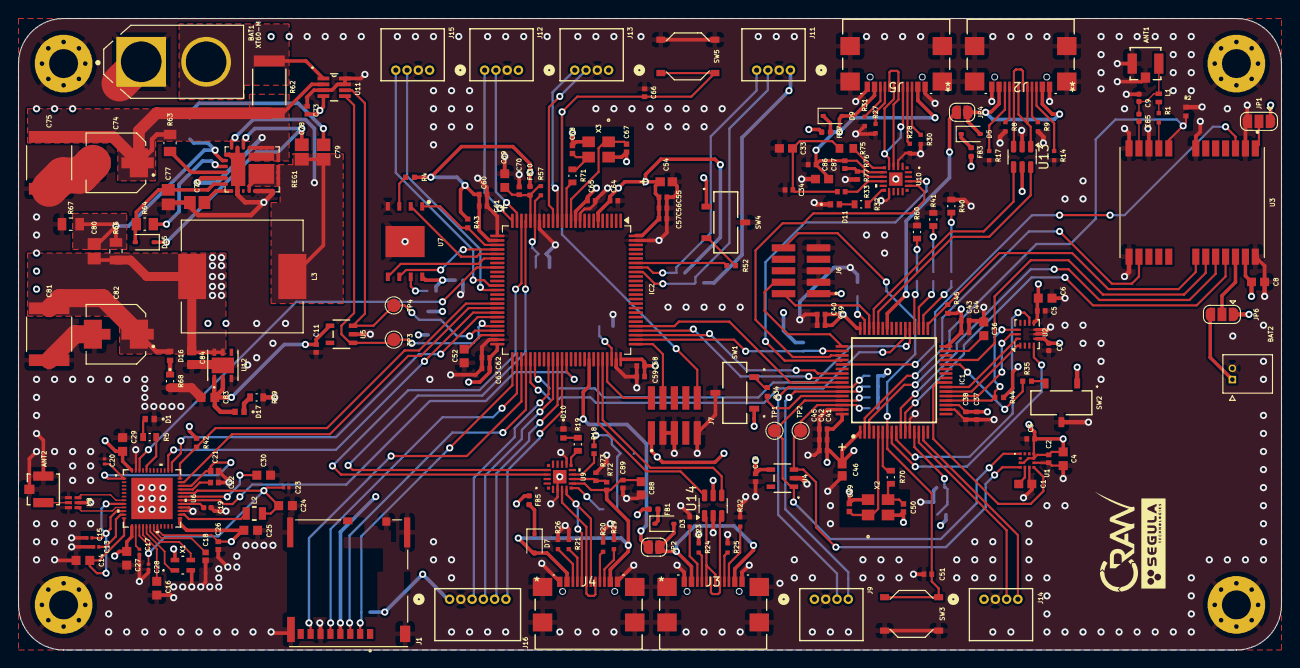
[picture p16: board Card_CRAN_SEGULA.kicad_pcb from above]

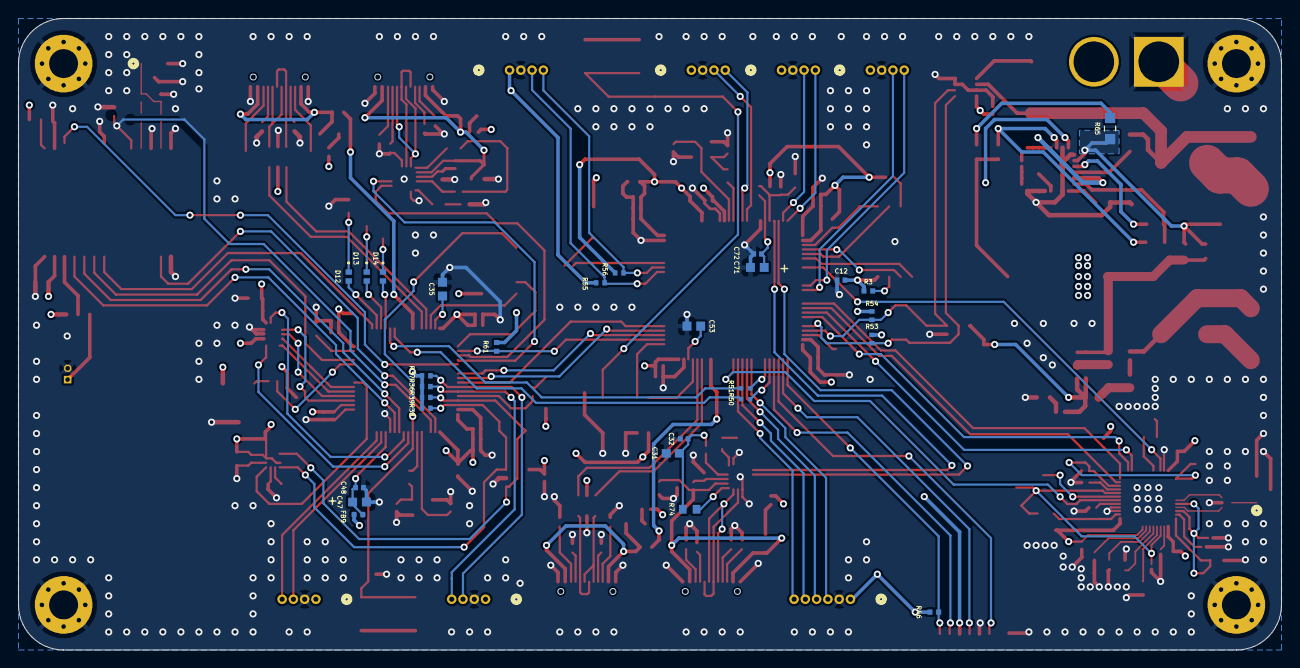
[picture p17: board Card_CRAN_SEGULA.kicad_pcb from below]

Board: 4 copper layers, 140.0 x 70.0 mm, 230 parts (28 on the bottom side), 183 nets.
