kslhuy/CartePCB/com_h753/com_H753VIT/com_H753VIT.ioc

Mcu.UserName=STM32H753VITx
PA0.GPIO_Label=UART_USB_TX
PA0.Signal=UART4_TX
PA1.GPIO_Label=UART_USB_RX
PA1.Signal=UART4_RX
PA2.Signal=USART2_TX
PA3.Signal=USART2_RX
PA4.Signal=SPI1_NSS
PA5.Signal=SPI1_SCK
PA6.Signal=SPI1_MISO
PA7.Signal=SPI1_MOSI
PB12.GPIO_Label=SD_NSS
PB12.Signal=SPI2_NSS
PB13.GPIO_Label=SD_MCK
PB13.Signal=SPI2_SCK
PB14.GPIO_Label=SD_MISO
PB14.Signal=SPI2_MISO
PB6.Signal=I2C1_SCL
PB7.Signal=I2C1_SDA
PC1.Signal=SPI2_MOSI
PC10.Signal=SPI3_SCK
PC11.Signal=SPI3_MISO
PC12.Signal=SPI3_MOSI
PC5.GPIO_Label=WIFI_INIT
PC5.Signal=GPIO_Input
PC6.GPIO_Label=WIFI_BUCKEN
PC6.Signal=GPIO_Output
PD8.GPIO_Label=UART_TX_NAV
PD8.Signal=USART3_TX
PD9.GPIO_Label=UART_RX_NAV
PD9.Signal=USART3_RX
PE11.GPIO_Label=WIFI_NSS
PE11.Signal=SPI4_NSS
PE12.GPIO_Label=WIFI_SCK
PE12.Signal=SPI4_SCK
PE13.GPIO_Label=WIFI_MISO
PE13.Signal=SPI4_MISO
PE14.GPIO_Label=WIFI_MOSI
PE14.Signal=SPI4_MOSI
PE7.Signal=UART7_RX
PE8.Signal=UART7_TX
