kslhuy/CartePCB/com_h753/com_H753VIT/Core/Inc/main.h

#define IMU_PKT_LEN       18
#define IMU_HEADER        0xAA
#define IMU_FOOTER        0x55
#define IMU_STATUS_VALID  0x01
