kslhuy/CartePCB/nav_f405_test/nav_f405_test/Core/Src/main.c

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
/* Includes ------------------------------------------------------------------*/
#include "main.h"

/* USER CODE BEGIN Includes */
#include "iim42652.h"
#include "neo_m9n.h"
#include <string.h>
#include <stdio.h>
/* USER CODE END Includes */

/* USER CODE BEGIN PD */

/* ── IMU chip-select pin (PA4, manually driven as GPIO) ── */
#define IMU_CS_PIN        GPIO_PIN_4
#define IMU_CS_PORT       GPIOA

/* GPS NEO-M9N SPI2 pins from the NAV schematic:
 *   PB10 = SPI2_SCK, PC2 = SPI2_MISO, PC3 = SPI2_MOSI, PB12 = CS.
 */
#define GPS_CS_PIN        GPIO_PIN_12
#define GPS_CS_PORT       GPIOB
#define GPS_POLL_PERIOD_MS 20u
#define GPS_POLL_BYTES      128u
#define GPS_DEBUG_PERIOD_MS 500u
#define IMU_DEBUG_UART_ENABLED 0u

/* ── SPI3 slave packet format (NAV → COM) ── */
#define NAV_PKT_HEADER    0xAAu
#define NAV_PKT_FOOTER    0x55u
#define NAV_PKT_SIZE      18u
/*  Byte layout:
 *    [0]      0xAA  header
 *    [1]      status  (0x01 = IMU data valid)
 *    [2..3]   accel_x   (big-endian int16)
 *    [4..5]   accel_y
 *    [6..7]   accel_z
 *    [8..9]   gyro_x
 *    [10..11]  gyro_y
 *    [12..13]  gyro_z
 *    [14..15]  temperature
 *    [16]     XOR checksum (bytes 0..15)
 *    [17]     0x55  footer
 */

/* USER CODE END PD */

I2C_HandleTypeDef hi2c1;

SPI_HandleTypeDef hspi1;
SPI_HandleTypeDef hspi3;

UART_HandleTypeDef huart4;
UART_HandleTypeDef huart6;

/* USER CODE BEGIN PV */

/* IIM-42652 IMU driver instance */
static IIM42652_Handle_t imu;
static IIM42652_Data_t   imu_data;

/* NEO-M9N GPS over SPI2 */
static SPI_HandleTypeDef hspi2;
static NEO_M9N_Handle_t  gps;
static NEO_M9N_Fix_t     gps_fix;

/* Double-buffered SPI3 slave TX (ping-pong) */
static uint8_t           spi3_tx_buf[2][NAV_PKT_SIZE];
static volatile uint8_t  spi3_ready_idx = 0;  /* index of latest COMPLETE packet */

/* Dummy RX buffer — absorbs master MOSI data, prevents OVR */
static uint8_t           spi3_rx_dummy[NAV_PKT_SIZE];

/* UART6 TX packet buffer (NAV → COM via UART) */
static uint8_t           uart6_tx_buf[NAV_PKT_SIZE];

/* UART debug buffer */
static char uart_buf[128];

/* USER CODE END PV */

void SystemClock_Config(void);
static void MX_GPIO_Init(void);
static void MX_UART4_Init(void);
static void MX_USART6_UART_Init(void);
static void MX_SPI1_Init(void);
static void MX_SPI3_Init(void);
static void MX_I2C1_Init(void);
/* USER CODE BEGIN PFP */
static void NAV_PackSpiBuffer(uint8_t *buf, const IIM42652_Data_t *d, uint8_t status);
static void MX_SPI2_GPS_Init(void);
/* USER CODE END PFP */

/* USER CODE BEGIN 0 */

/**
 * @brief  Pack IMU data into NAV SPI3 slave TX packet.
 */
static void NAV_PackSpiBuffer(uint8_t *buf, const IIM42652_Data_t *d, uint8_t status)
{
    buf[0]  = NAV_PKT_HEADER;
    buf[1]  = status;
    buf[2]  = (uint8_t)(d->accel_x >> 8);
    buf[3]  = (uint8_t)(d->accel_x);
    buf[4]  = (uint8_t)(d->accel_y >> 8);
    buf[5]  = (uint8_t)(d->accel_y);
    buf[6]  = (uint8_t)(d->accel_z >> 8);
    buf[7]  = (uint8_t)(d->accel_z);
    buf[8]  = (uint8_t)(d->gyro_x >> 8);
    buf[9]  = (uint8_t)(d->gyro_x);
    buf[10] = (uint8_t)(d->gyro_y >> 8);
    buf[11] = (uint8_t)(d->gyro_y);
    buf[12] = (uint8_t)(d->gyro_z >> 8);
    buf[13] = (uint8_t)(d->gyro_z);
    buf[14] = (uint8_t)(d->temperature >> 8);
    buf[15] = (uint8_t)(d->temperature);

    /* XOR checksum over bytes 0..15 */
    uint8_t chk = 0;
    for (int i = 0; i < 16; i++) chk ^= buf[i];
    buf[16] = chk;
    buf[17] = NAV_PKT_FOOTER;
}

/**
 * @brief  Configure SPI2 for the NEO-M9N GPS module.
 */
static void MX_SPI2_GPS_Init(void)
{
    GPIO_InitTypeDef gpio = {0};

    __HAL_RCC_GPIOB_CLK_ENABLE();
    __HAL_RCC_GPIOC_CLK_ENABLE();
    __HAL_RCC_SPI2_CLK_ENABLE();

    HAL_GPIO_WritePin(GPS_CS_PORT, GPS_CS_PIN, GPIO_PIN_SET);

    gpio.Pin       = GPIO_PIN_10;
    gpio.Mode      = GPIO_MODE_AF_PP;
    gpio.Pull      = GPIO_NOPULL;
    gpio.Speed     = GPIO_SPEED_FREQ_VERY_HIGH;
    gpio.Alternate = GPIO_AF5_SPI2;
    HAL_GPIO_Init(GPIOB, &gpio);

    gpio.Pin       = GPIO_PIN_2 | GPIO_PIN_3;
    gpio.Mode      = GPIO_MODE_AF_PP;
    gpio.Pull      = GPIO_NOPULL;
    gpio.Speed     = GPIO_SPEED_FREQ_VERY_HIGH;
    gpio.Alternate = GPIO_AF5_SPI2;
    HAL_GPIO_Init(GPIOC, &gpio);

    gpio.Pin   = GPS_CS_PIN;
    gpio.Mode  = GPIO_MODE_OUTPUT_PP;
    gpio.Pull  = GPIO_PULLUP;
    gpio.Speed = GPIO_SPEED_FREQ_VERY_HIGH;
    HAL_GPIO_Init(GPS_CS_PORT, &gpio);
    HAL_GPIO_WritePin(GPS_CS_PORT, GPS_CS_PIN, GPIO_PIN_SET);

    hspi2.Instance = SPI2;
    hspi2.Init.Mode = SPI_MODE_MASTER;
    hspi2.Init.Direction = SPI_DIRECTION_2LINES;
    hspi2.Init.DataSize = SPI_DATASIZE_8BIT;
    hspi2.Init.CLKPolarity = SPI_POLARITY_LOW;
    hspi2.Init.CLKPhase = SPI_PHASE_1EDGE;
    hspi2.Init.NSS = SPI_NSS_SOFT;
    hspi2.Init.BaudRatePrescaler = SPI_BAUDRATEPRESCALER_64;
    hspi2.Init.FirstBit = SPI_FIRSTBIT_MSB;
    hspi2.Init.TIMode = SPI_TIMODE_DISABLE;
    hspi2.Init.CRCCalculation = SPI_CRCCALCULATION_DISABLE;
    hspi2.Init.CRCPolynomial = 10;
    if (HAL_SPI_Init(&hspi2) != HAL_OK)
    {
        Error_Handler();
    }
}

/* ═══════════════════════════════════════════════════════════════════════════
 *  Bare-metal DMA for SPI3 slave TX/RX
 *  DMA1 Stream 5 Ch 0 = SPI3_TX   (memory → SPI3->DR)
 *  DMA1 Stream 0 Ch 0 = SPI3_RX   (SPI3->DR → memory, absorbs MOSI)
 * ═══════════════════════════════════════════════════════════════════════════*/

/**
 * @brief  One-time DMA + SPI3 setup.  Call AFTER MX_SPI3_Init().
 */
static void SPI3_DMA_Init(void)
{
    __HAL_RCC_DMA1_CLK_ENABLE();

    /* ── TX: DMA1 Stream 5, Channel 0 ── */
    DMA1_Stream5->CR  = 0;
    while (DMA1_Stream5->CR & DMA_SxCR_EN);          /* wait disabled     */
    DMA1_Stream5->CR  = (0u  << DMA_SxCR_CHSEL_Pos)  /* channel 0         */
                      | DMA_SxCR_MINC                 /* memory increment  */
                      | (1u  << DMA_SxCR_DIR_Pos);    /* mem → periph      */
    DMA1_Stream5->PAR = (uint32_t)&SPI3->DR;
    DMA1_Stream5->FCR = 0;                            /* direct mode       */

    /* ── RX: DMA1 Stream 0, Channel 0 (absorbs MOSI → no OVR) ── */
    DMA1_Stream0->CR  = 0;
    while (DMA1_Stream0->CR & DMA_SxCR_EN);
    DMA1_Stream0->CR  = (0u  << DMA_SxCR_CHSEL_Pos)
                      | DMA_SxCR_MINC
                      | (0u  << DMA_SxCR_DIR_Pos);    /* periph → mem      */
    DMA1_Stream0->PAR = (uint32_t)&SPI3->DR;
    DMA1_Stream0->FCR = 0;

    /* Enable SPI3 DMA requests */
    SPI3->CR2 |= SPI_CR2_TXDMAEN | SPI_CR2_RXDMAEN;
}

/**
 * @brief  (Re-)arm SPI3 slave DMA with a fresh TX buffer.
 *         Call from EXTI callback or init.  Safe to call from ISR.
 */
static void SPI3_DMA_Arm(const uint8_t *tx_buf, uint8_t *rx_buf, uint16_t len)
{
    /* 1) Disable both DMA streams */
    DMA1_Stream5->CR &= ~DMA_SxCR_EN;
    DMA1_Stream0->CR &= ~DMA_SxCR_EN;
    while (DMA1_Stream5->CR & DMA_SxCR_EN);
    while (DMA1_Stream0->CR & DMA_SxCR_EN);

    /* 2) Clear all DMA status flags */
    DMA1->HIFCR = DMA_HIFCR_CTCIF5 | DMA_HIFCR_CHTIF5
                | DMA_HIFCR_CTEIF5 | DMA_HIFCR_CDMEIF5 | DMA_HIFCR_CFEIF5;
    DMA1->LIFCR = DMA_LIFCR_CTCIF0 | DMA_LIFCR_CHTIF0
                | DMA_LIFCR_CTEIF0 | DMA_LIFCR_CDMEIF0 | DMA_LIFCR_CFEIF0;

    /* 3) Disable SPI so we can reset the TX/RX path cleanly */
    SPI3->CR1 &= ~SPI_CR1_SPE;

    /* 4) Clear any pending OVR (read DR then SR) */
    (void)SPI3->DR;
    (void)SPI3->SR;

    /* 5) Configure TX DMA */
    DMA1_Stream5->M0AR = (uint32_t)tx_buf;
    DMA1_Stream5->NDTR = len;

    /* 6) Configure RX DMA */
    DMA1_Stream0->M0AR = (uint32_t)rx_buf;
    DMA1_Stream0->NDTR = len;

    /* 7) Enable RX stream first (so it's ready to drain), then TX */
    DMA1_Stream0->CR |= DMA_SxCR_EN;
    DMA1_Stream5->CR |= DMA_SxCR_EN;

    /* 8) Re-enable SPI — TXE fires immediately, DMA loads byte 0 into DR
     *    before master pulls CS LOW.                                      */
    SPI3->CR1 |= SPI_CR1_SPE;
}

/* USER CODE END 0 */

/**
  * @brief  The application entry point.
  * @retval int
  */
int main(void)
{

  /* MCU Configuration--------------------------------------------------------*/

  /* Reset of all peripherals, Initializes the Flash interface and the Systick. */
  HAL_Init();

  /* Configure the system clock */
  SystemClock_Config();

  /* Initialize all configured peripherals */
  MX_GPIO_Init();
  MX_UART4_Init();
  MX_USART6_UART_Init();
  MX_SPI1_Init();
  MX_SPI3_Init();
  MX_I2C1_Init();
  /* USER CODE BEGIN 2 */

  MX_SPI2_GPS_Init();
  NEO_M9N_Init(&gps, &hspi2, GPS_CS_PORT, GPS_CS_PIN);
  HAL_UART_Transmit(&huart4, (uint8_t *)"GPS SPI READY\r\n", 15, HAL_MAX_DELAY);

  /* ── Reconfigure PA4 as GPIO output for manual IMU chip-select ── */
  {
      GPIO_InitTypeDef gpio = {0};
      gpio.Pin   = IMU_CS_PIN;
      gpio.Mode  = GPIO_MODE_OUTPUT_PP;
      gpio.Pull  = GPIO_NOPULL;
      gpio.Speed = GPIO_SPEED_FREQ_VERY_HIGH;
      HAL_GPIO_Init(IMU_CS_PORT, &gpio);
      HAL_GPIO_WritePin(IMU_CS_PORT, IMU_CS_PIN, GPIO_PIN_SET); /* CS idle high */
  }

  /* ── Initialise IIM-42652 IMU on SPI1 ── */
  if (IIM42652_Init(&imu, &hspi1, IMU_CS_PORT, IMU_CS_PIN) != HAL_OK)
  {
      /* IMU init failed (WHO_AM_I mismatch or wiring) — blink PB13 fast */
      HAL_UART_Transmit(&huart4, (uint8_t *)"IMU FAIL\r\n", 10, HAL_MAX_DELAY);
      while (1)
      {
          HAL_GPIO_TogglePin(GPIOB, GPIO_PIN_13);
          HAL_Delay(100);
      }
  }
  HAL_UART_Transmit(&huart4, (uint8_t *)"IMU OK\r\n", 9, HAL_MAX_DELAY);

  /* ── Prepare SPI3 slave double-buffers ── */
  memset(spi3_tx_buf, 0, sizeof(spi3_tx_buf));
  spi3_tx_buf[0][0]  = NAV_PKT_HEADER;
  spi3_tx_buf[0][17] = NAV_PKT_FOOTER;
  spi3_tx_buf[1][0]  = NAV_PKT_HEADER;
  spi3_tx_buf[1][17] = NAV_PKT_FOOTER;

  /* ── PA15 as SPI3_NSS (hardware) + EXTI rising edge for DMA re-arm ── */
  {
      /* 1) Configure PA15 as AF6 = SPI3_NSS (hardware slave-select).
       *    The SPI peripheral tracks this pin and resets the shift
       *    register / bit counter on every CS deassertion.              */
      GPIO_InitTypeDef gpio = {0};
      gpio.Pin       = GPIO_PIN_15;
      gpio.Mode      = GPIO_MODE_AF_PP;
      gpio.Pull      = GPIO_PULLUP;
      gpio.Speed     = GPIO_SPEED_FREQ_HIGH;
      gpio.Alternate = GPIO_AF6_SPI3;
      HAL_GPIO_Init(GPIOA, &gpio);

      /* 2) Layer EXTI15 on top via registers — the GPIO stays in AF mode
       *    but EXTI still fires because the input path is always active. */
      __HAL_RCC_SYSCFG_CLK_ENABLE();
      SYSCFG->EXTICR[3] &= ~SYSCFG_EXTICR4_EXTI15;   /* map to PA        */
      EXTI->RTSR       |=  (1u << 15);                 /* rising edge      */
      EXTI->FTSR       &= ~(1u << 15);                 /* no falling edge  */
      EXTI->IMR        |=  (1u << 15);                 /* unmask           */
      HAL_NVIC_SetPriority(EXTI15_10_IRQn, 1, 0);
      HAL_NVIC_EnableIRQ(EXTI15_10_IRQn);
  }

  /* ── Set up bare-metal DMA for SPI3 slave (bypasses HAL completely) ── */
  SPI3_DMA_Init();

  /* Arm SPI3 slave with buffer 0 — DMA will feed bytes to SPI DR in
   * hardware with zero CPU involvement.  No more IRQ latency issues.   */
  spi3_ready_idx = 0;
  SPI3_DMA_Arm(spi3_tx_buf[0], spi3_rx_dummy, NAV_PKT_SIZE);

  /* USER CODE END 2 */

  /* Infinite loop */
  /* USER CODE BEGIN WHILE */
  while (1)
  {
    /* 1) Read IMU sensor data via SPI1 */
    IIM42652_ReadSensorData(&imu, &imu_data);

    /* 2) Pack fresh data into the INACTIVE SPI3 TX buffer, then publish it */
    {
        uint8_t wr = spi3_ready_idx ^ 1;          /* write to other buffer   */
        NAV_PackSpiBuffer(spi3_tx_buf[wr], &imu_data, 0x01);
        spi3_ready_idx = wr;                       /* atomic 8-bit store      */
    }

    /* 2b) Also send the same IMU packet over USART6 → COM H753 USART3 */
    {
        static uint32_t last_uart_tx = 0;
        uint32_t now_u = HAL_GetTick();
        if (now_u - last_uart_tx >= 10u)  /* ~100 Hz UART TX rate */
        {
            last_uart_tx = now_u;
            NAV_PackSpiBuffer(uart6_tx_buf, &imu_data, 0x01);
            HAL_UART_Transmit(&huart6, uart6_tx_buf, NAV_PKT_SIZE, 5);
        }
    }

    /* 2c) Poll NEO-M9N GPS over SPI2. */
    {
        static uint32_t last_gps_poll = 0;
        uint32_t now_gps = HAL_GetTick();
        if (now_gps - last_gps_poll >= GPS_POLL_PERIOD_MS)
        {
            last_gps_poll = now_gps;
            (void)NEO_M9N_Poll(&gps, &gps_fix, GPS_POLL_BYTES);
            HAL_GPIO_WritePin(LED_C_NAV_GPIO_Port, LED_C_NAV_Pin,
                              (gps_fix.valid != 0u) ? GPIO_PIN_SET : GPIO_PIN_RESET);
        }
    }

    /* 3) Debug UART every 10 ms (~100 Hz) — fast enough for calibration */
    #if IMU_DEBUG_UART_ENABLED
    {
        static uint32_t last_print = 0;
        uint32_t now = HAL_GetTick();
        if (now - last_print >= 10u)
        {
            last_print = now;

            int len = snprintf(uart_buf, sizeof(uart_buf),
                "AX:%6d AY:%6d AZ:%6d GX:%6d GY:%6d GZ:%6d T:%d\r\n",
                imu_data.accel_x, imu_data.accel_y, imu_data.accel_z,
                imu_data.gyro_x,  imu_data.gyro_y,  imu_data.gyro_z,
                imu_data.temperature);
            HAL_UART_Transmit(&huart4, (uint8_t *)uart_buf, len, HAL_MAX_DELAY);
        }
    }
    #endif

    /* 3b) GPS debug UART once per second. */
    {
        static uint32_t last_gps_print = 0;
        uint32_t now_gps_dbg = HAL_GetTick();
        if (now_gps_dbg - last_gps_print >= GPS_DEBUG_PERIOD_MS)
        {
            int len;

            last_gps_print = now_gps_dbg;
            if (gps_fix.valid != 0u)
            {
                long lat = (long)gps_fix.latitude_e7;
                long lon = (long)gps_fix.longitude_e7;
                long alt = (long)gps_fix.altitude_cm;
                long lat_abs = (lat < 0) ? -lat : lat;
                long lon_abs = (lon < 0) ? -lon : lon;
                long alt_abs = (alt < 0) ? -alt : alt;

                len = snprintf(uart_buf, sizeof(uart_buf),
                    "GPS FIX UTC:%s LAT:%c%ld.%07ld LON:%c%ld.%07ld SAT:%u ALT:%c%ld.%02ldm\r\n",
                    gps_fix.utc_time,
                    (lat < 0) ? '-' : '+', lat_abs / 10000000L, lat_abs % 10000000L,
                    (lon < 0) ? '-' : '+', lon_abs / 10000000L, lon_abs % 10000000L,
                    gps_fix.satellites,
                    (alt < 0) ? '-' : '+', alt_abs / 100L, alt_abs % 100L);
            }
            else
            {
                len = snprintf(uart_buf, sizeof(uart_buf),
                    "GPS NOFIX Q:%u SAT:%u BY:%lu NMEA:%lu\r\n",
                    gps_fix.fix_quality, gps_fix.satellites,
                    (unsigned long)gps.bytes_rx,
                    (unsigned long)gps.sentences_rx);
            }

            HAL_UART_Transmit(&huart4, (uint8_t *)uart_buf, len, HAL_MAX_DELAY);
        }
    }

    /* 4) Heartbeat LED (PB14) every 500 ms */
    {
        static uint32_t last_blink = 0;
        uint32_t now_b = HAL_GetTick();
        if (now_b - last_blink >= 500u)
        {
            last_blink = now_b;
            HAL_GPIO_TogglePin(GPIOB, GPIO_PIN_14);
        }
    }

    /* No delay — read IMU as fast as possible (8 kHz ODR) */
    /* USER CODE END WHILE */

    /* USER CODE BEGIN 3 */
  }
  /* USER CODE END 3 */
}

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
/* USER CODE BEGIN 4 */

/**
 * @brief  EXTI callback — PA15 rising edge = CS went HIGH (master done).
 *         Re-arm DMA from byte 0 with latest IMU data.
 *         DMA handles all byte-level TX/RX in hardware — no HAL involved.
 */
void HAL_GPIO_EXTI_Callback(uint16_t GPIO_Pin)
{
    if (GPIO_Pin == GPIO_PIN_15)
    {
        SPI3_DMA_Arm(spi3_tx_buf[spi3_ready_idx], spi3_rx_dummy, NAV_PKT_SIZE);
    }
}

/* USER CODE END 4 */
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
